DewanPieterse/AudioRadar/Report/images/pd.png

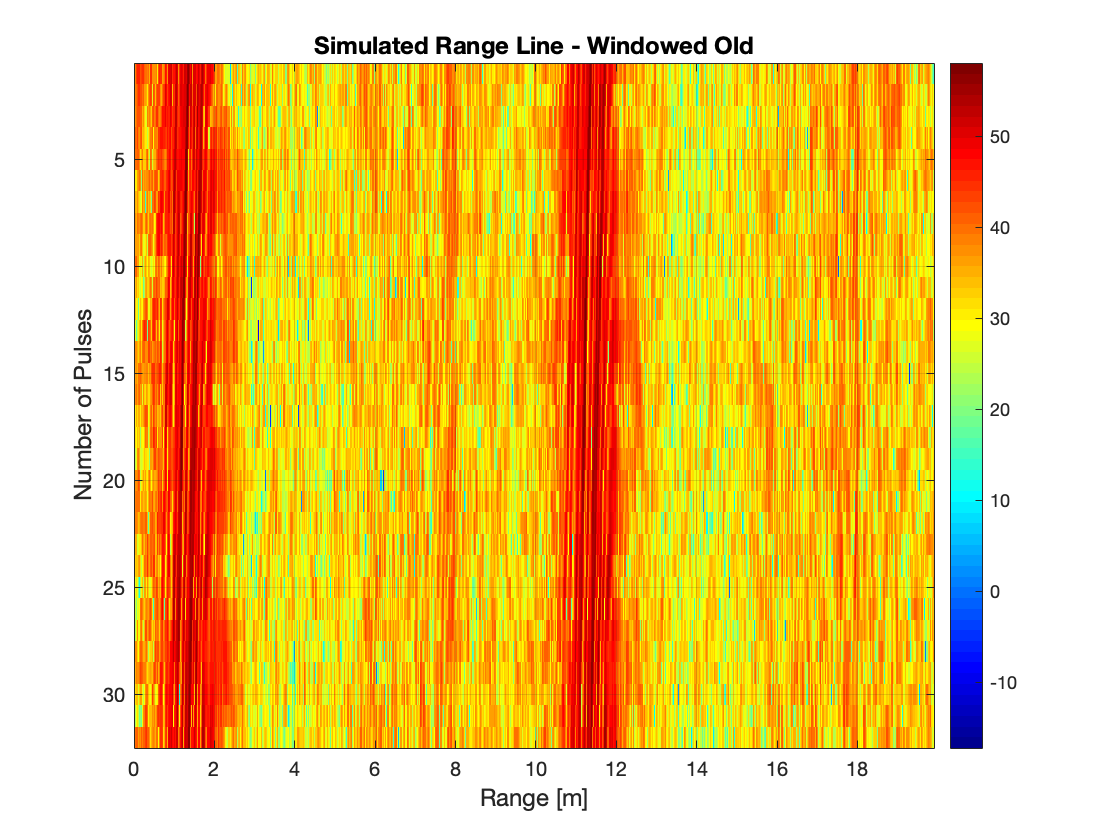
Report/images/pd.png
