DewanPieterse/AudioRadar/Matlab/Testing Mics and Speakers/IMG_0957.JPG

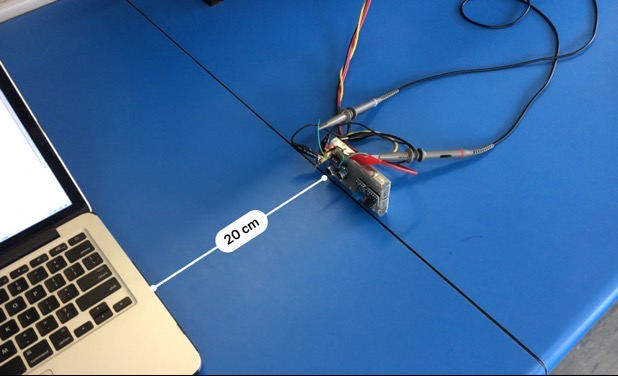
Matlab/Testing Mics and Speakers/IMG_0957.JPG
