DewanPieterse/AudioRadar/Report/Abbreviations.tex

{\smallest\chapter*{Abbreviations and Initialisms}\label{chap:Abbreviations and Initialisms}}\addcontentsline{toc}{chapter}{Abbreviations and Initialisms}\\
\hrule
\begin{table}[h!]
	\centering\renewcommand{\arraystretch}{1.5}
	\begin{tabular}{p{2cm} p{0.5cm} p{15cm}}
    ADC & & Analogue to Digital Converter \\
    CPU & & Central Processing Unit \\
	CW & & Continuous Wave \\
    DAC & & Digital to Analogue Converter \\
    dBsm & & Decibels square meter \\
    DSP & & Digital Signal Processing \\
	FFT & & Fast Fourier Transform \\
	FMCW & & Frequency Modulated Continuous Wave \\
    HAT & & Hardware Attached on Top \\
    ISM & & Industrial, Scientific and Medical frequency band \\
    MDF & & Medium Density Fibreboard \\
    MIT & & Massachusetts Institute of Technology \\
    PCB & & Printed Circuit Board \\
	PRI  & & Pulse Repetition Interval \\
    PRF & & Pulse Repetition Frequency \\
    Radar & & Radio Detection and Ranging \\
    RAM & & Random Access Memory \\
    RF & & Radio Frequency \\
	SAR & & Synthetic Aperture Radar \\
    SNR & & Signal to Noise Ratio \\
    SSH & & Secure Shell \\
    THD & & Total Harmonic Distortion \\
    UART & & Universal Asynchronous Receiver/Transmitter \\
    UCT & & University of Cape Town \\
    USB & & Universal Serial Bus \\
	\end{tabular}
\end{table}

\newpage
