DewanPieterse/AudioRadar/Report/FrontPage.tex

\thispagestyle{empty}
{\Huge 
\begin{center}
    Development of a Small-Scale, Educational, Embedded, Audio Radar System
    % Title
\end{center}}

\vskip 5mm
\begin{center}
    
\end{center}

\vskip 5mm
\begin{center}
    Presented by:\\
    \textbf{Dewan Pieterse}\\
    PTRDEW001\\
    Department of Electrical and Electronics Engineering\\
    University of Cape Town
\end{center}

\vskip 10mm
\begin{center}
Prepared for:\\
    \textbf{Dr. Mohammed Yunus Abdul Gaffar}\\ % and Mr. Jarryd Son} \\
    Department of Electrical and Electronics Engineering\\
    University of Cape Town
\end{center}

\vskip 10mm
\begin{center}{\scriptsize
Submitted to the Department of Electrical Engineering at the University of Cape Town in partial fulfilment of the academic requirements for a Bachelor of Science degree in Mechatronics Engineering}
\end{center}

\vskip 5mm
\begin{center}{\bf \today}\end{center}

\begin{center}\textbf{Key words:} Education, Radar, Audio, Embedded Systems, Low-Cost\end{center}\newpage
