DewanPieterse/AudioRadar/Report/Plagiarism.tex

{\smallest\chapter*{Plagiarism Declaration}\label{chap:Plagiarism Declaration}}\addcontentsline{toc}{chapter}{Plagiarism Declaration}\\
\hrule

\vskip 10mm
\begin{enumerate}
\item I know that plagiarism is wrong. Plagiarism is to use another's work and pretend that it is one's own.
\item I have used the IEEE convention for citation and referencing. Each contribution to, and quotation in, this report from the work(s) of other people has been attributed, and has been cited and referenced.
\item This report is my own work.
\item I have not allowed, and will not allow, anyone to copy my work with the intention of passing it off as their own work or part thereof.
\end{enumerate}

\vskip 15mm
\ldots\ldots\ldots\ldots\ldots\ldots\ldots\ldots\ldots\ldots
\\D. Pieterse
\vskip12mm
\ldots\ldots\ldots\ldots\ldots\ldots\ldots\ldots\ldots\ldots
\\Date

\fancyfoot[C]{\thepage}
\pagestyle{plain}
\newpage
