DewanPieterse/AudioRadar/Report/images/9000.pdf

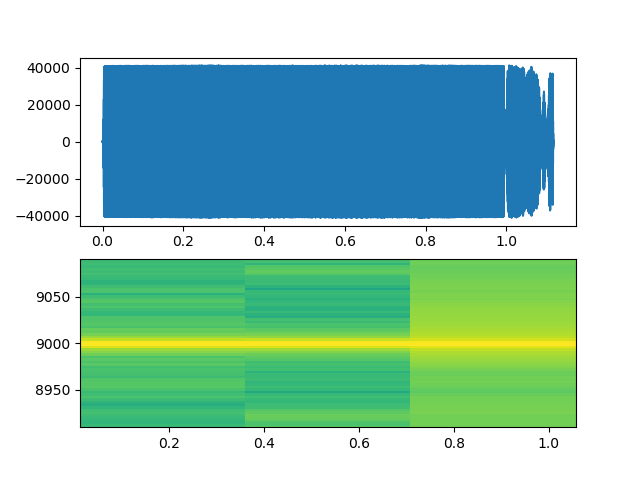
[picture p3: page 1]
