DewanPieterse/AudioRadar/Report/images/ampfreq.pdf

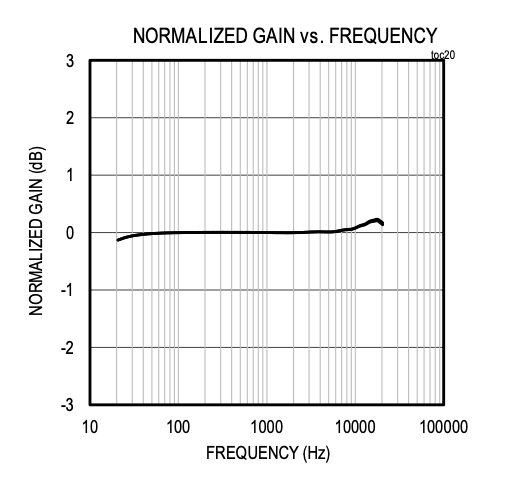
[picture p4: page 1]
