DewanPieterse/AudioRadar/Report/images/boxToward.pdf

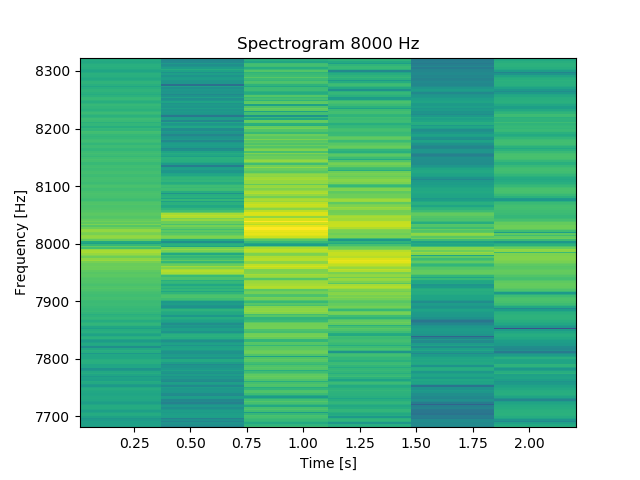
[picture p5: page 1]
