DewanPieterse/AudioRadar/Report/images/chirp.pdf

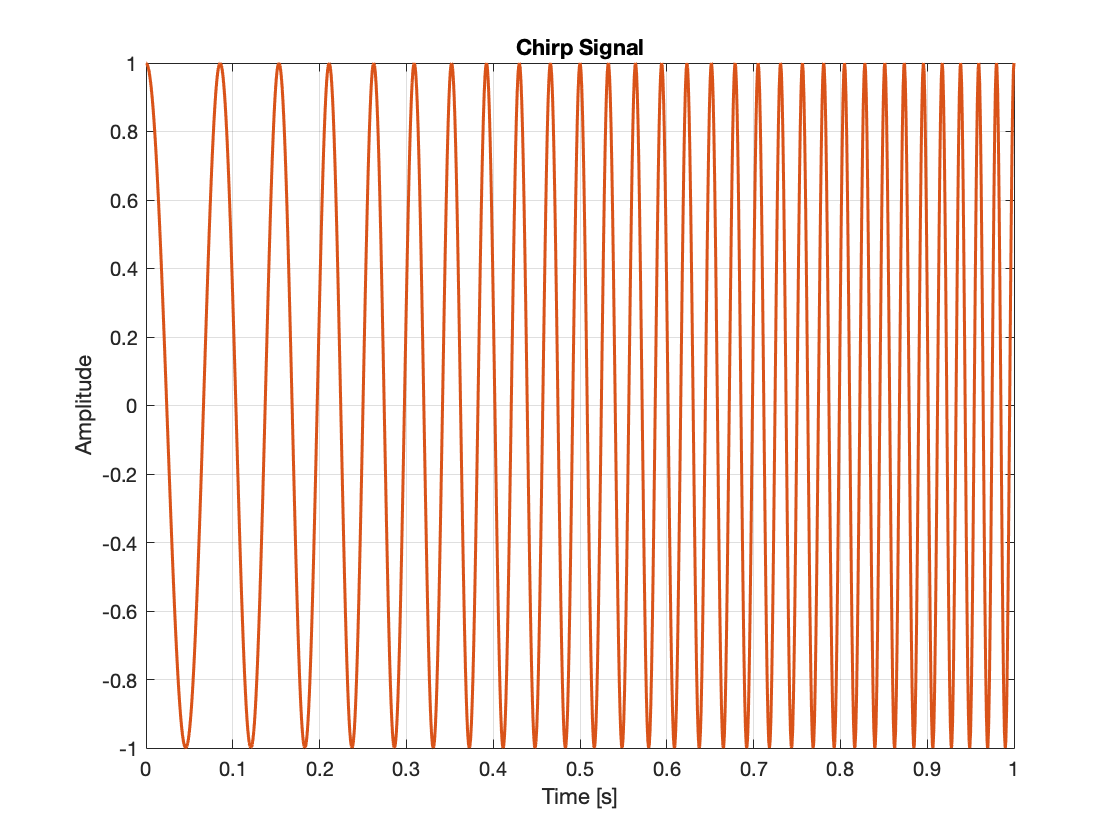
[picture p6: page 1]
