DewanPieterse/AudioRadar/Report/images/chirpFFT.pdf

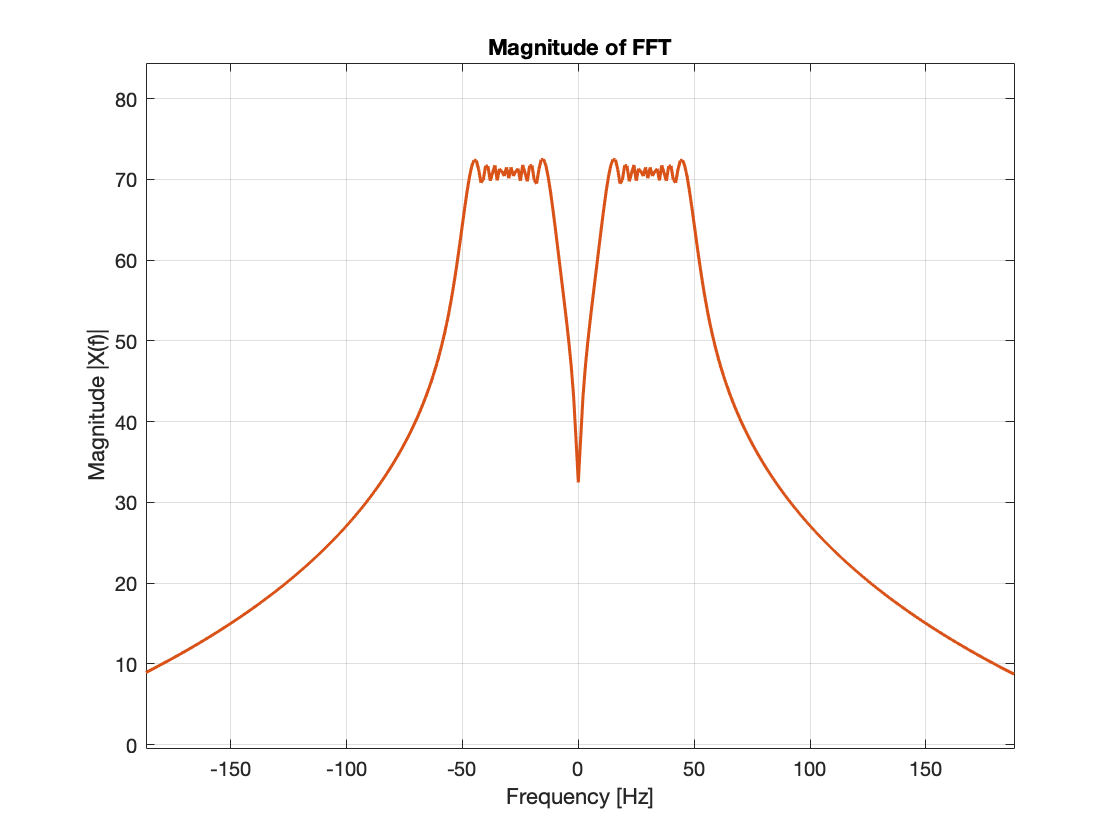
[picture p7: page 1]
