DewanPieterse/AudioRadar/Report/images/consistPDResults1.pdf

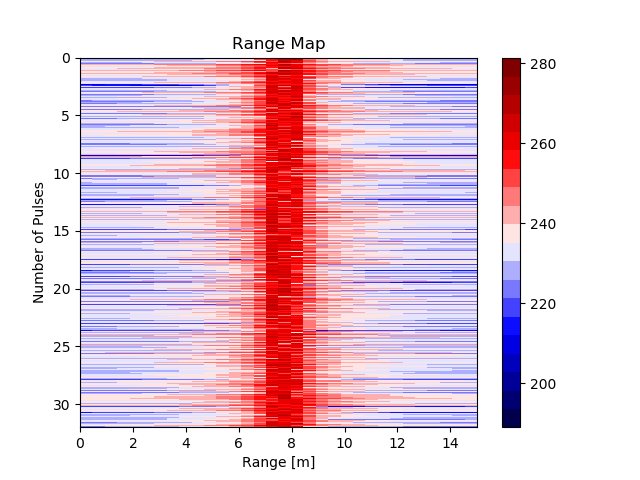
[picture p8: page 1]
