DewanPieterse/AudioRadar/Report/images/consistPDResults2.pdf

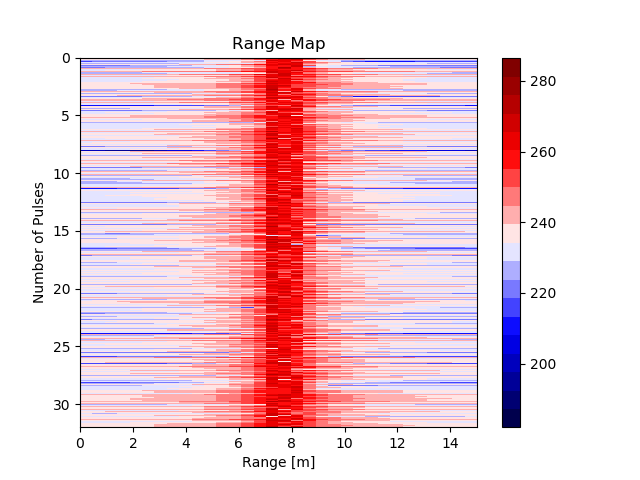
[picture p9: page 1]
