DewanPieterse/AudioRadar/Report/images/consistPDResults3.pdf

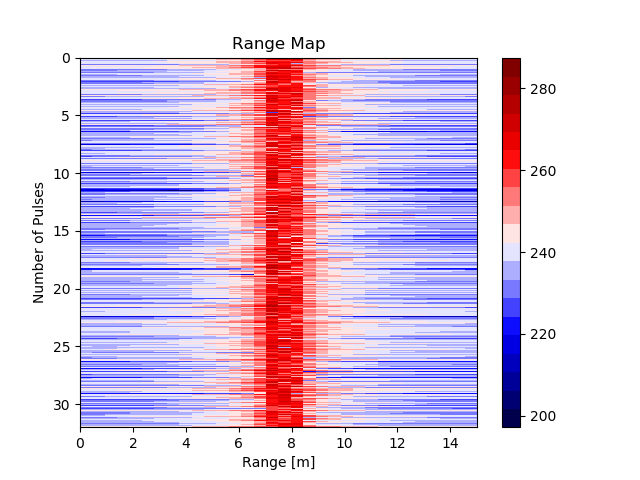
[picture p10: page 1]
