DewanPieterse/AudioRadar/Report/images/CW.pdf

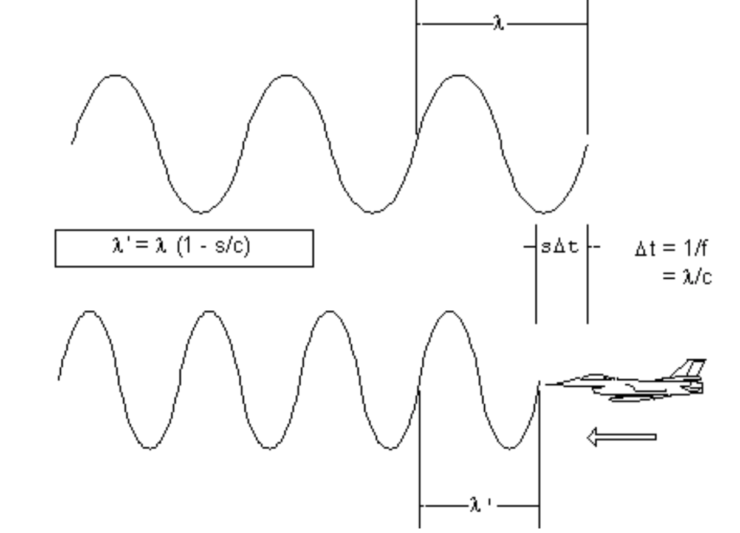
[picture p11: page 1]
