DewanPieterse/AudioRadar/Report/images/CWResults1.pdf

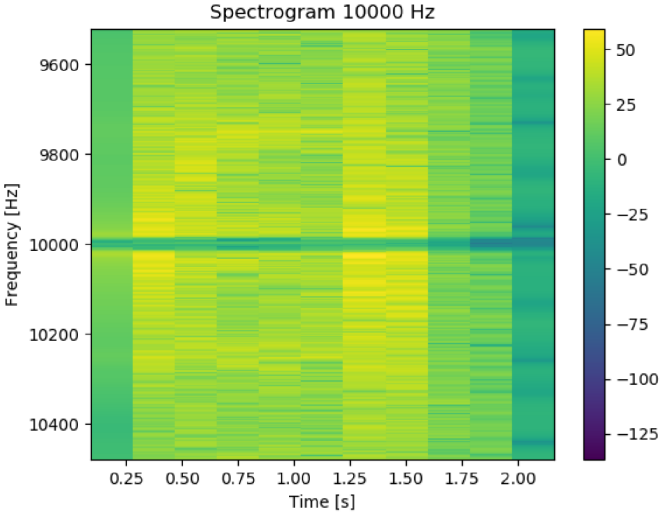
[picture p12: page 1]
