DewanPieterse/AudioRadar/Report/images/CWResults2.pdf

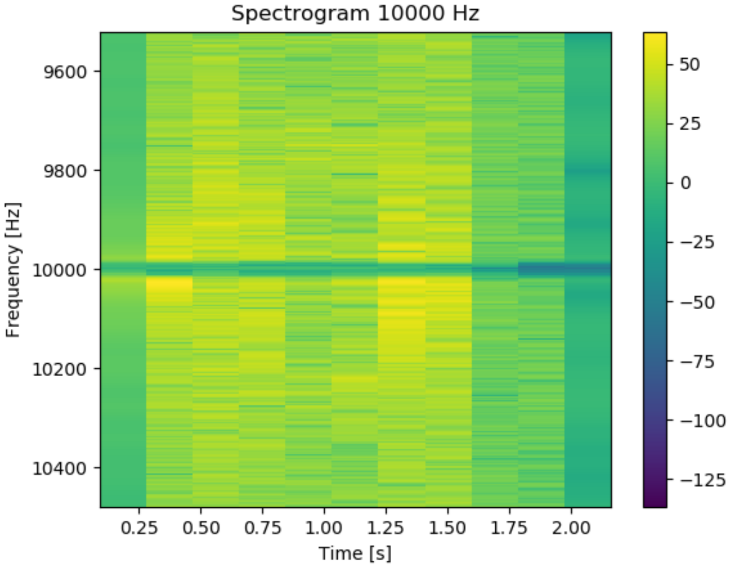
[picture p13: page 1]
