DewanPieterse/AudioRadar/Report/images/CWResults3.pdf

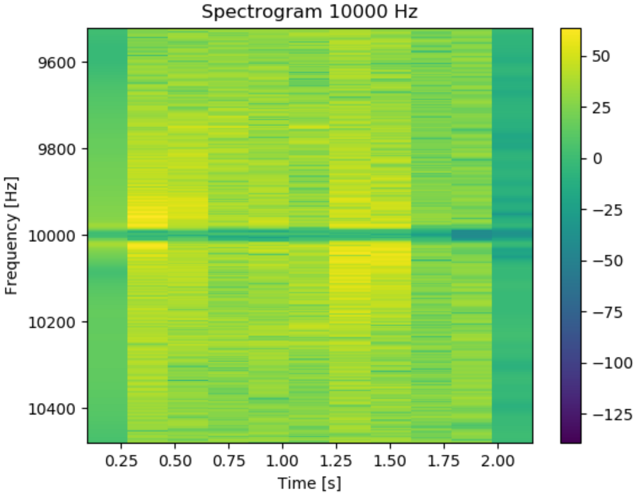
[picture p14: page 1]
