DewanPieterse/AudioRadar/Report/images/cwSpec.pdf

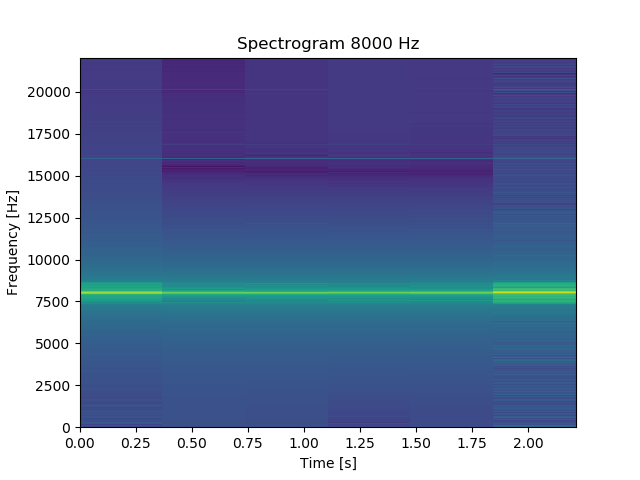
[picture p15: page 1]
