DewanPieterse/AudioRadar/Report/images/cwSpec1.pdf

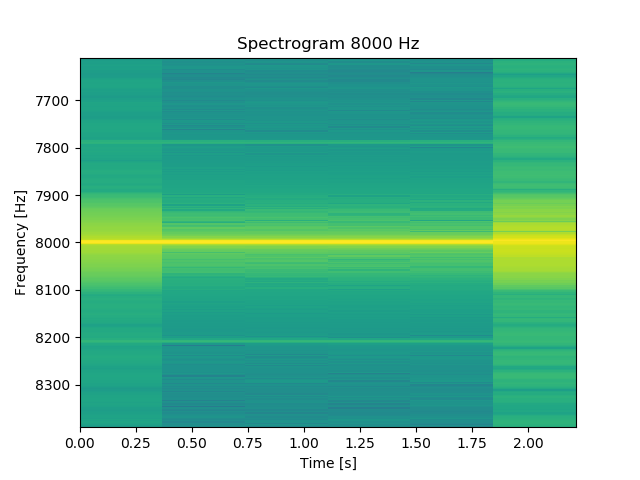
[picture p16: page 1]
