DewanPieterse/AudioRadar/Report/images/dist.pdf

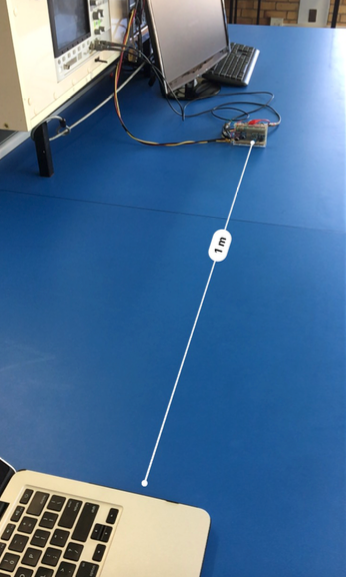
[picture p17: page 1]
