DewanPieterse/AudioRadar/Report/images/downmix.pdf

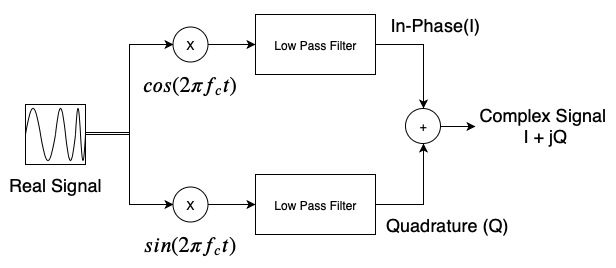
[picture p18: page 1]
