DewanPieterse/AudioRadar/Report/images/enc1.pdf

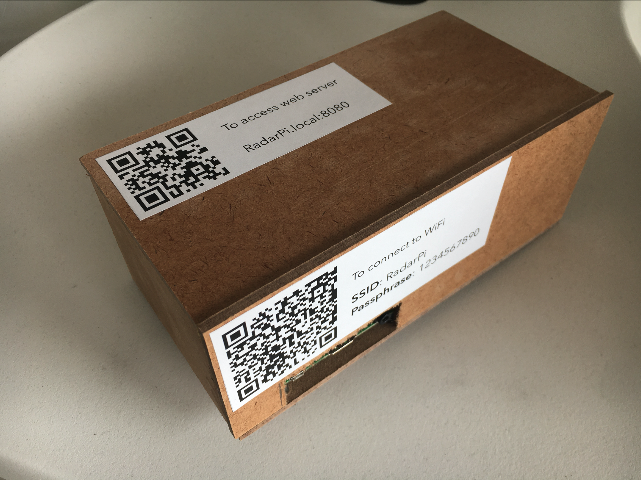
[picture p19: page 1]
