DewanPieterse/AudioRadar/Report/images/enc2.pdf

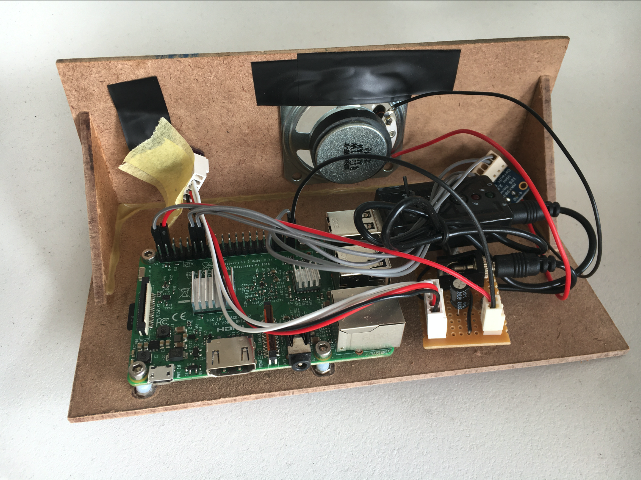
[picture p20: page 1]
