DewanPieterse/AudioRadar/Report/images/enc3.pdf

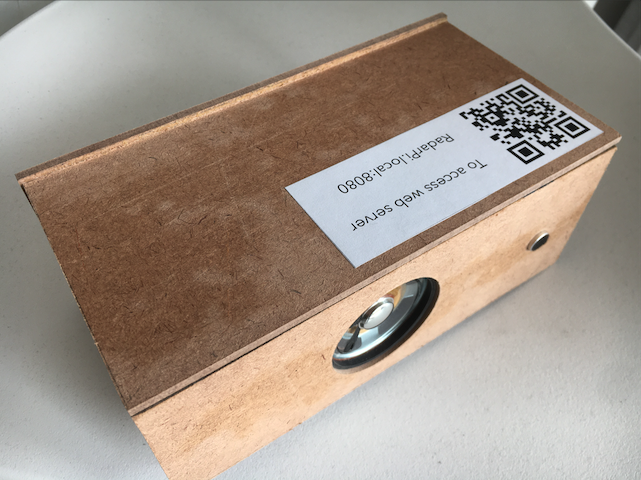
[picture p21: page 1]
