DewanPieterse/AudioRadar/Report/images/fftTeensy.pdf

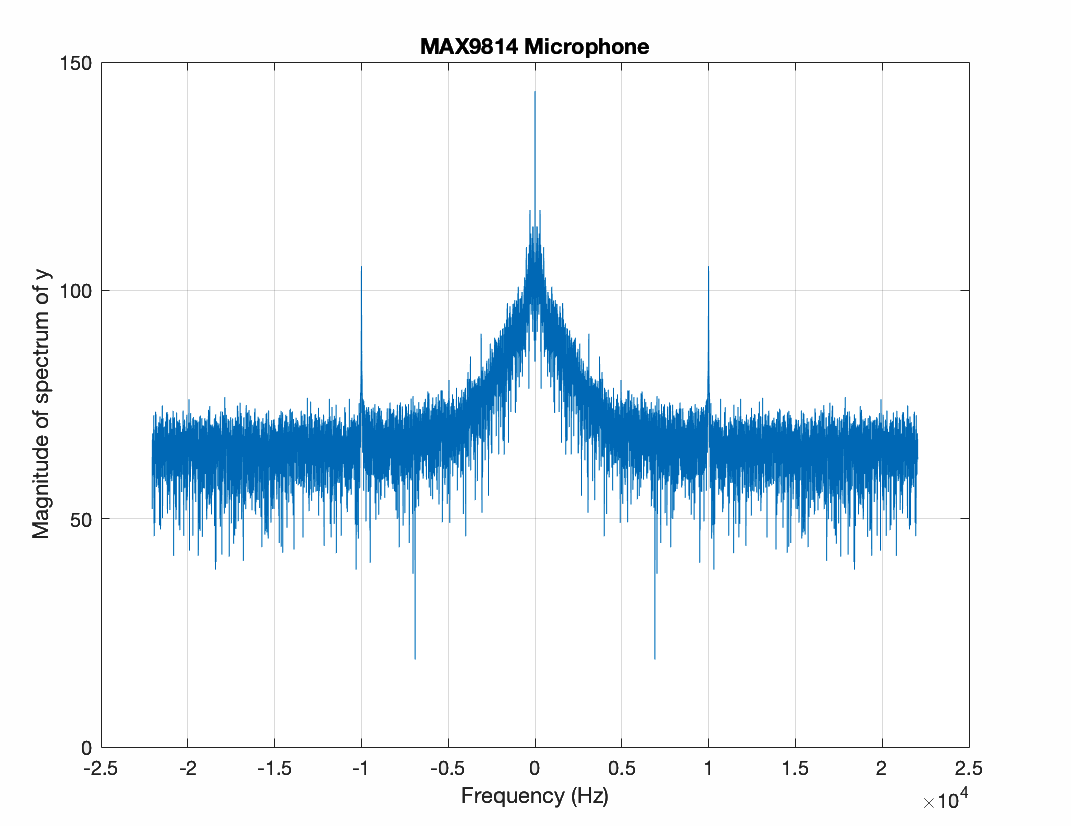
[picture p22: page 1]
