DewanPieterse/AudioRadar/Report/images/floorplan.pdf

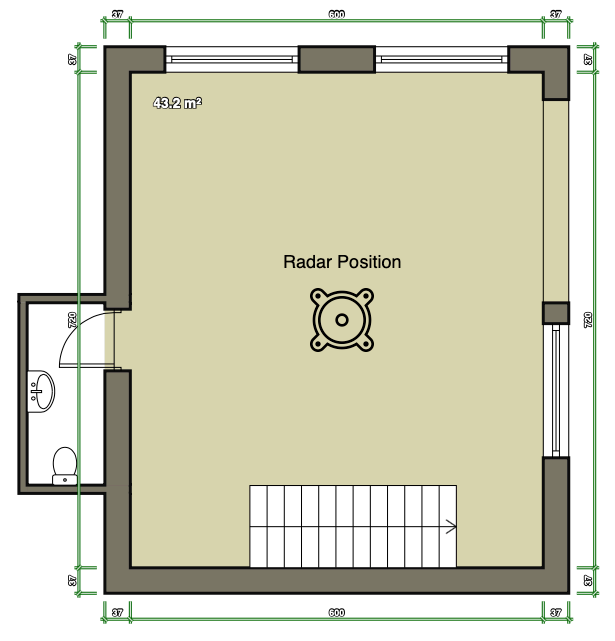
[picture p23: page 1]
