DewanPieterse/AudioRadar/Report/images/FMCW.pdf

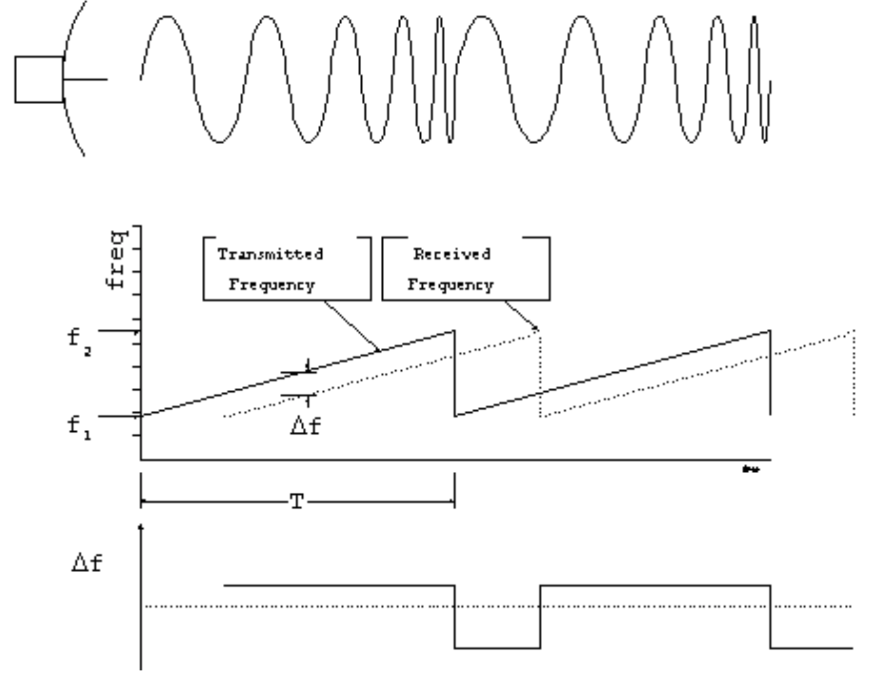
[picture p24: page 1]
