DewanPieterse/AudioRadar/Report/images/gainVSfreq.pdf

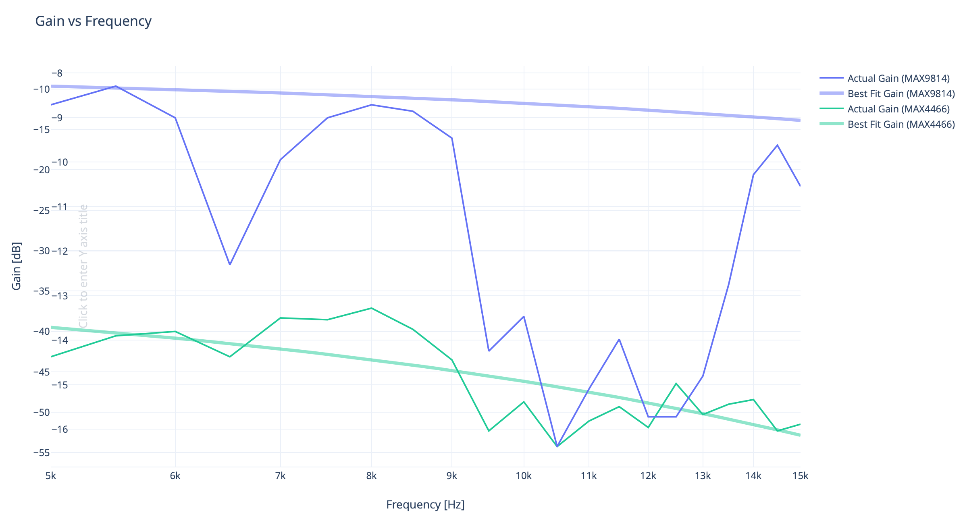
[picture p25: page 1]
