DewanPieterse/AudioRadar/Report/images/golfball.pdf

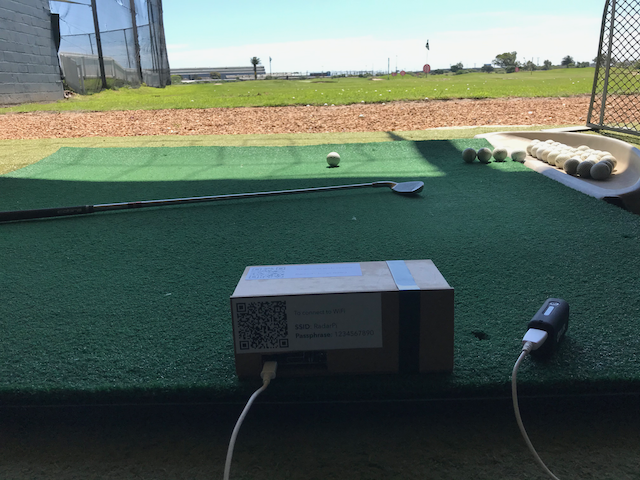
[picture p26: page 1]
