DewanPieterse/AudioRadar/Report/images/hamming.pdf

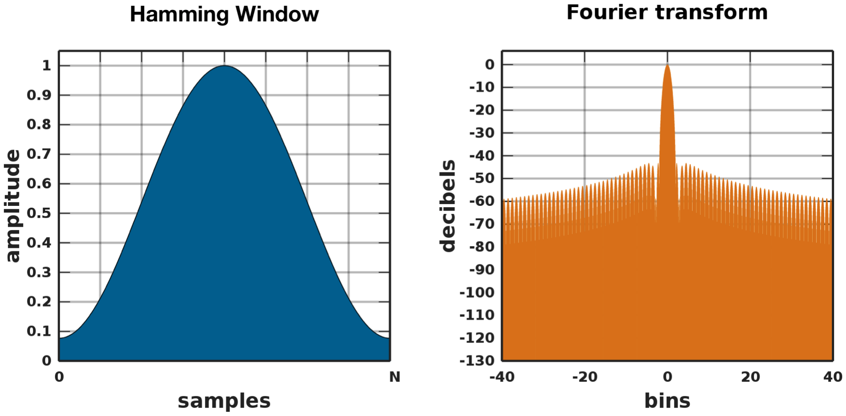
[picture p27: page 1]
