DewanPieterse/AudioRadar/Report/images/handmoving.pdf

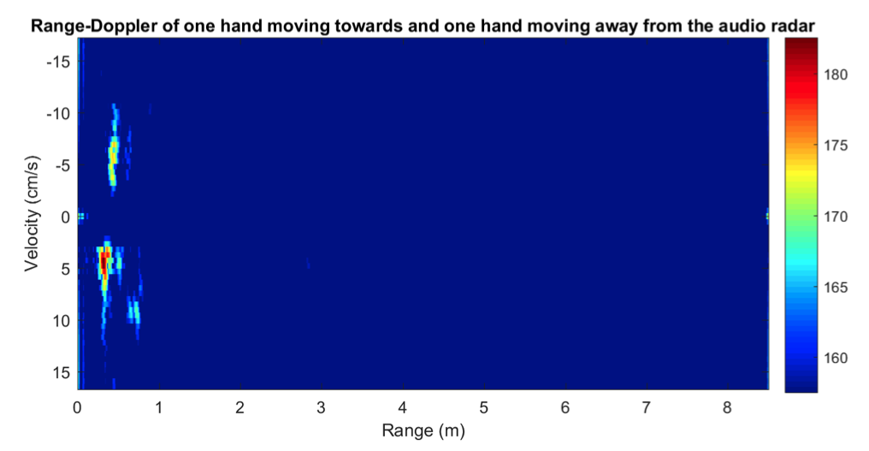
[picture p28: page 1]
