DewanPieterse/AudioRadar/Report/images/handsfingers.pdf

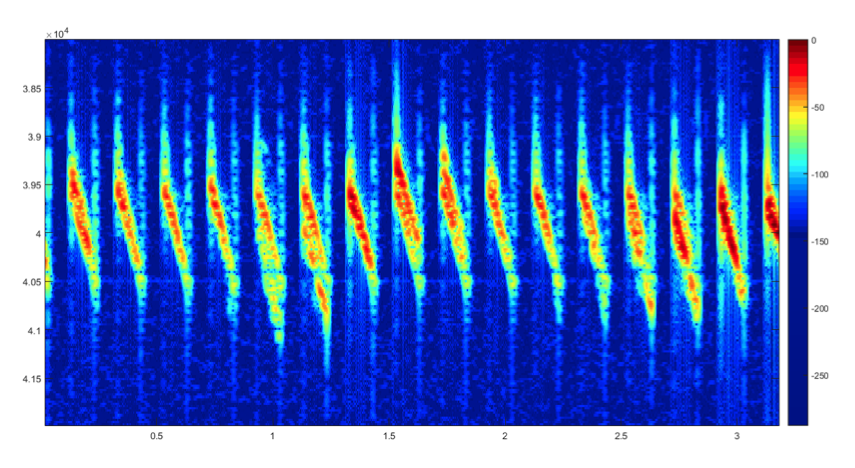
[picture p29: page 1]
