DewanPieterse/AudioRadar/Report/images/implementationCircuit.pdf

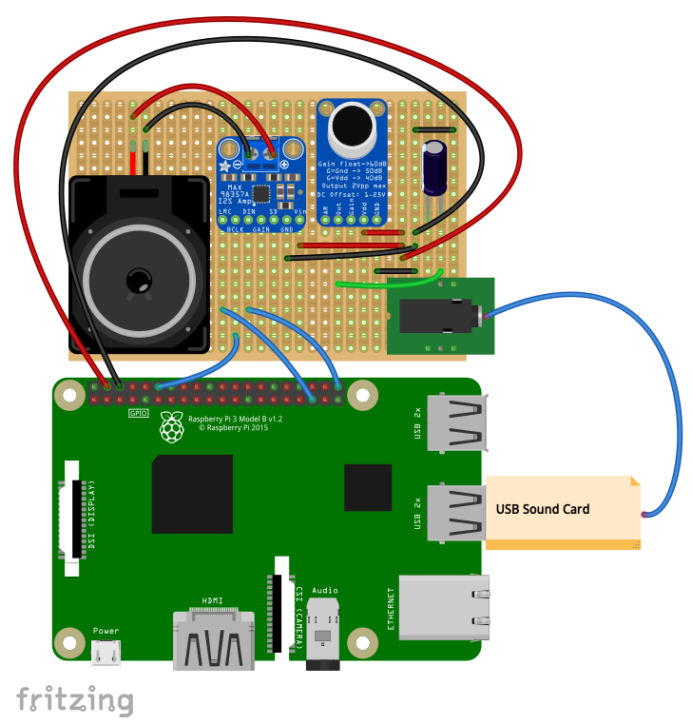
[picture p30: page 1]
