DewanPieterse/AudioRadar/Report/images/lidOff.pdf

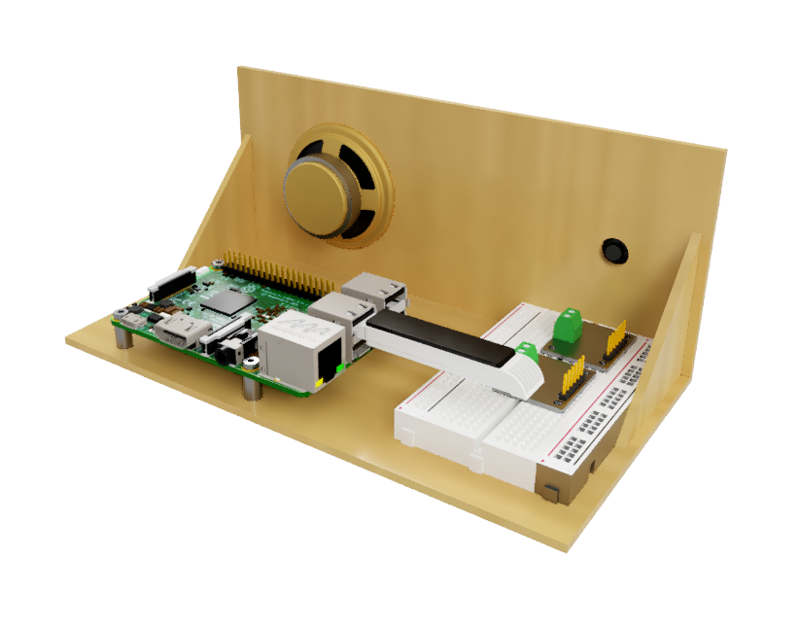
[picture p31: page 1]
