DewanPieterse/AudioRadar/Report/images/lidOn.pdf

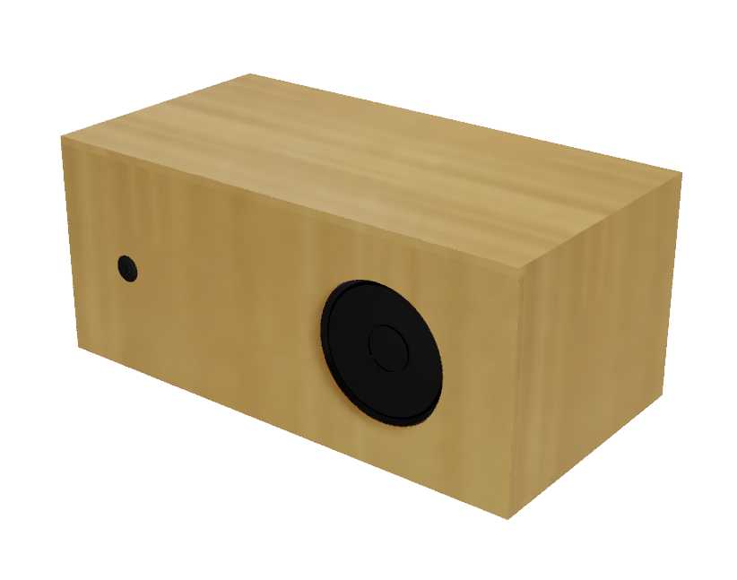
[picture p32: page 1]
