DewanPieterse/AudioRadar/Report/images/lowcostminiradar.pdf

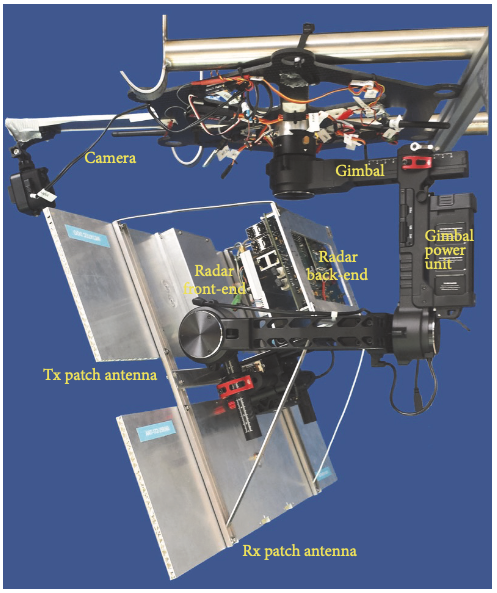
[picture p33: page 1]
