DewanPieterse/AudioRadar/Report/images/lowcostradar.pdf

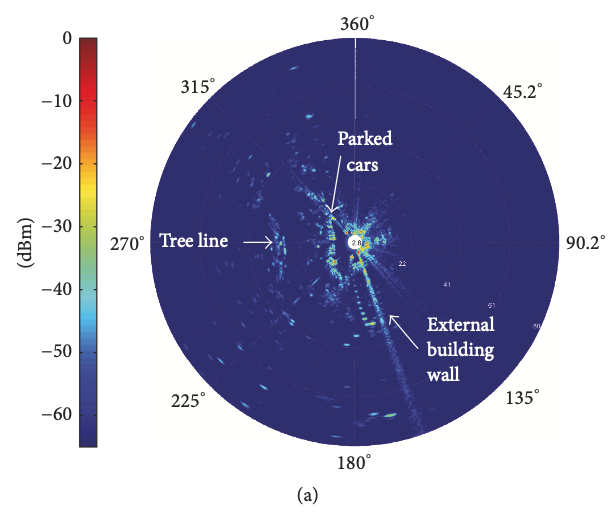
[picture p34: page 1]
