DewanPieterse/AudioRadar/Report/images/lpfDownmix.pdf

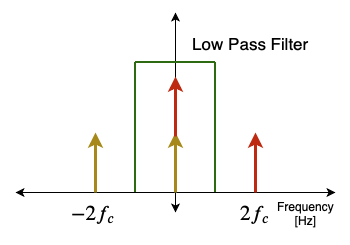
[picture p35: page 1]
