DewanPieterse/AudioRadar/Report/images/MAX4466.pdf

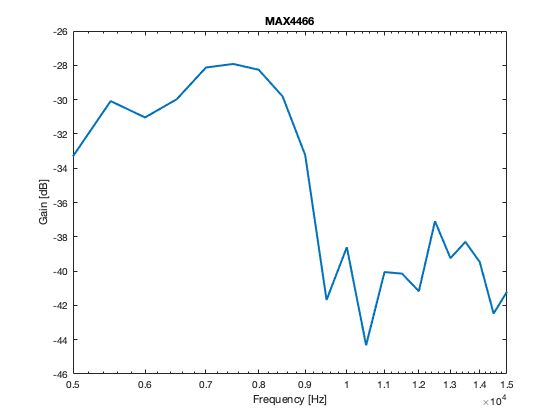
[picture p36: page 1]
