DewanPieterse/AudioRadar/Report/images/MAX9814.pdf

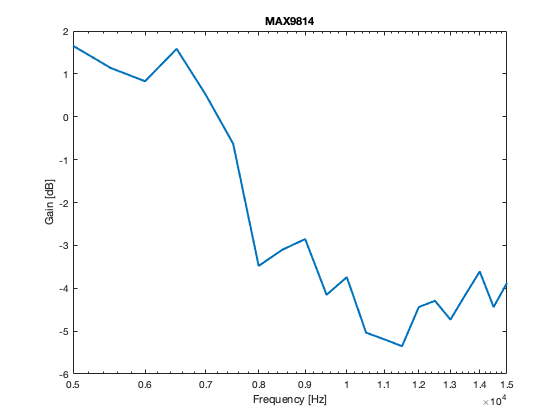
[picture p37: page 1]
