DewanPieterse/AudioRadar/Report/images/mcp3008.pdf

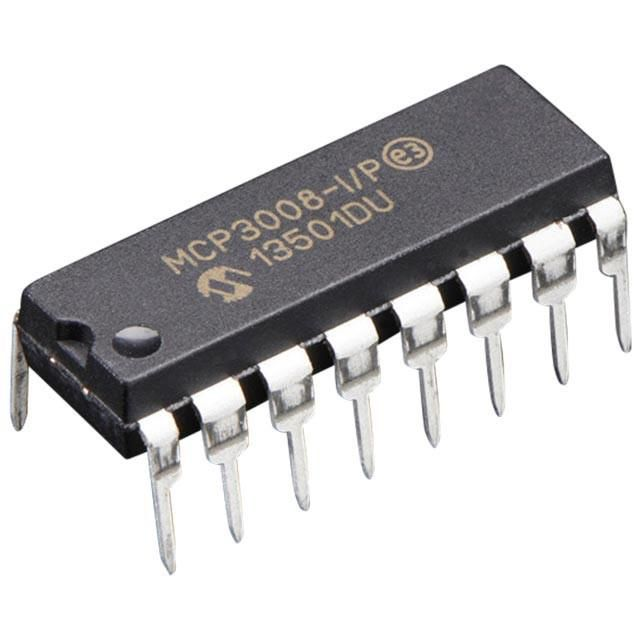
[picture p38: page 1]
