DewanPieterse/AudioRadar/Report/images/mf.pdf

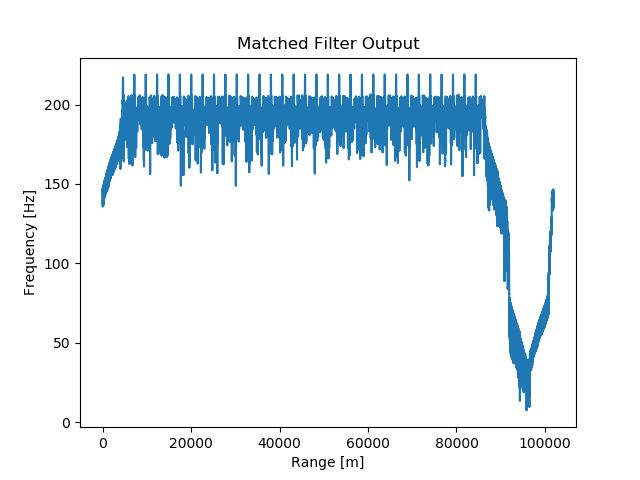
[picture p39: page 1]
