DewanPieterse/AudioRadar/Report/images/mfIll.pdf

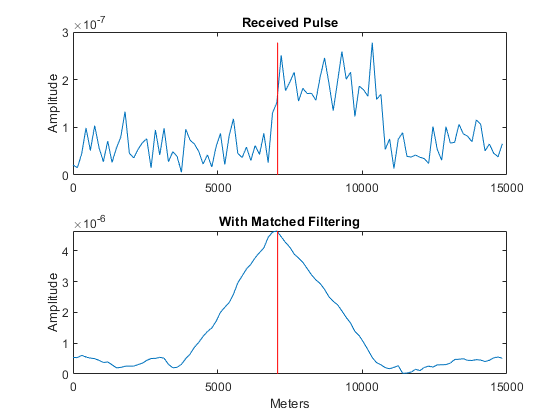
[picture p40: page 1]
