DewanPieterse/AudioRadar/Report/images/mic.pdf

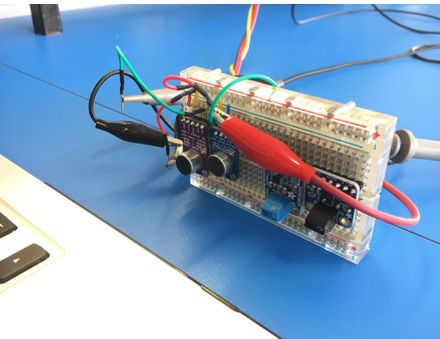
[picture p41: page 1]
