DewanPieterse/AudioRadar/Report/images/MITRadar.pdf

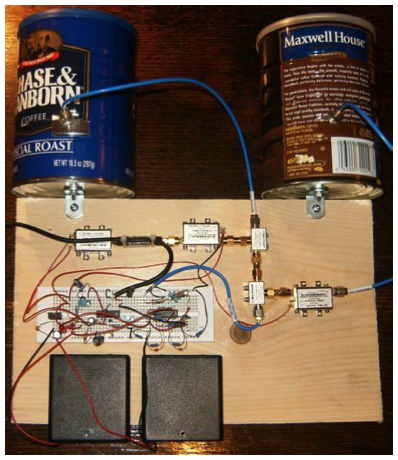
[picture p42: page 1]
