DewanPieterse/AudioRadar/Report/images/notchApplied.pdf

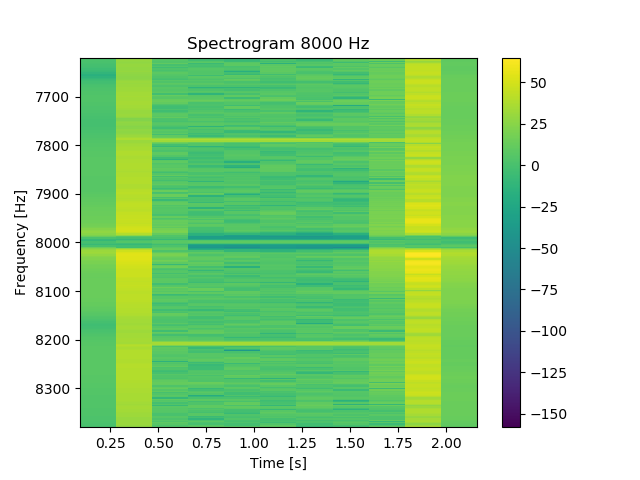
[picture p43: page 1]
