DewanPieterse/AudioRadar/Report/images/overview.pdf

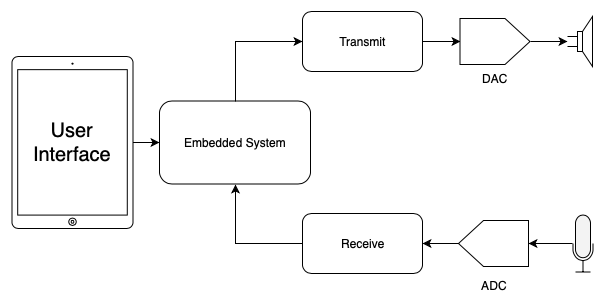
[picture p44: page 1]
