DewanPieterse/AudioRadar/Report/images/PRI.pdf

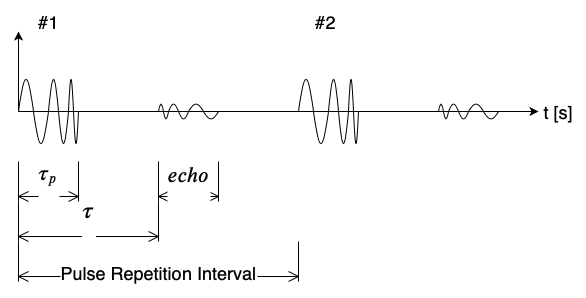
[picture p45: page 1]
