DewanPieterse/AudioRadar/Report/images/ra1.pdf

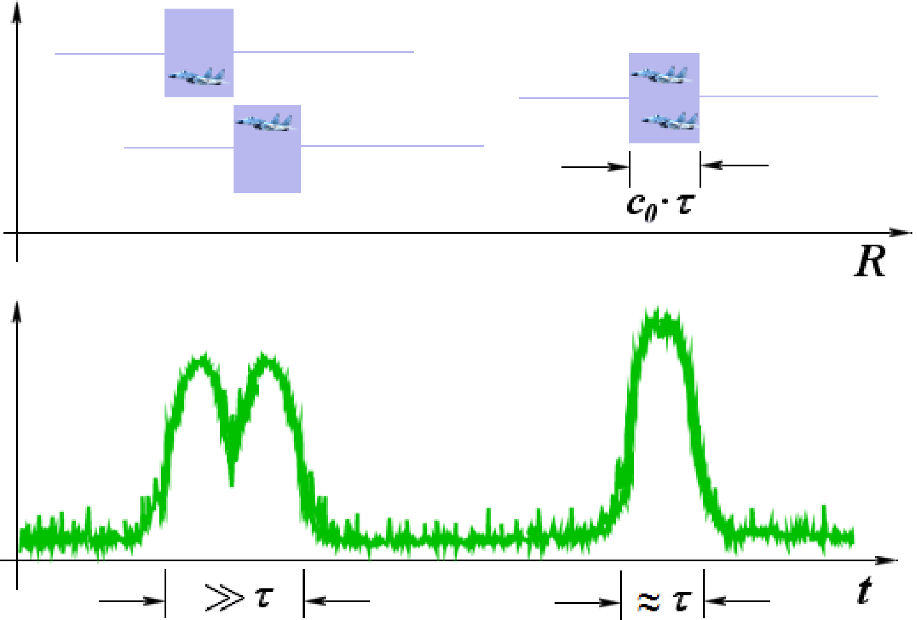
[picture p46: page 1]
