DewanPieterse/AudioRadar/Report/images/rangeConcept.pdf

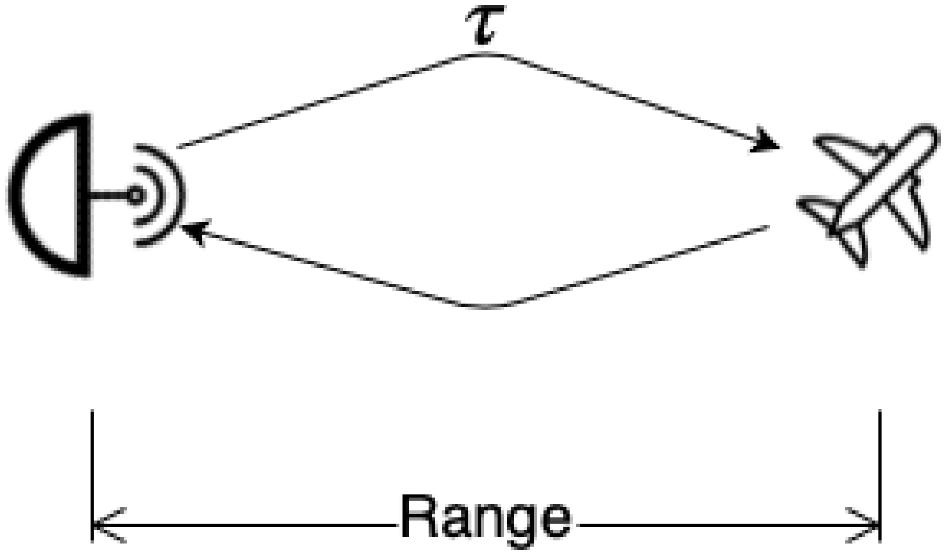
[picture p47: page 1]
