DewanPieterse/AudioRadar/Report/images/rangeline2Matrix.pdf

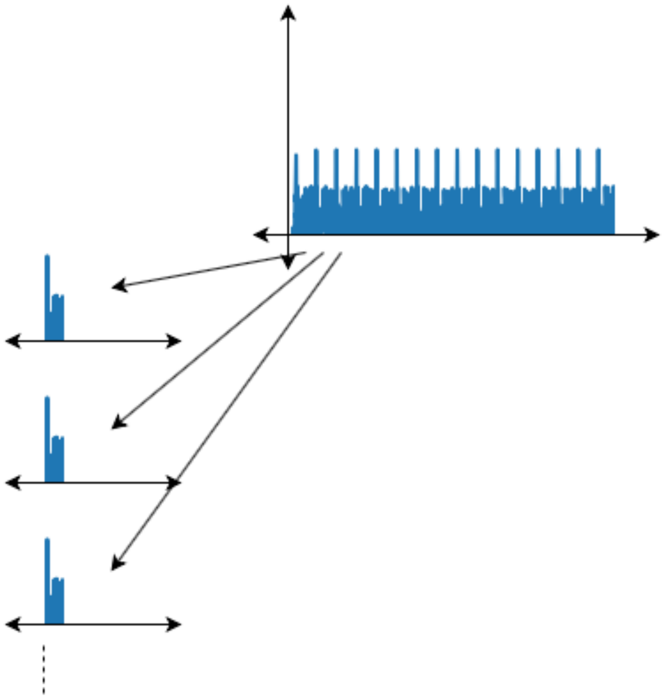
[picture p48: page 1]
