DewanPieterse/AudioRadar/Report/images/rangemap.pdf

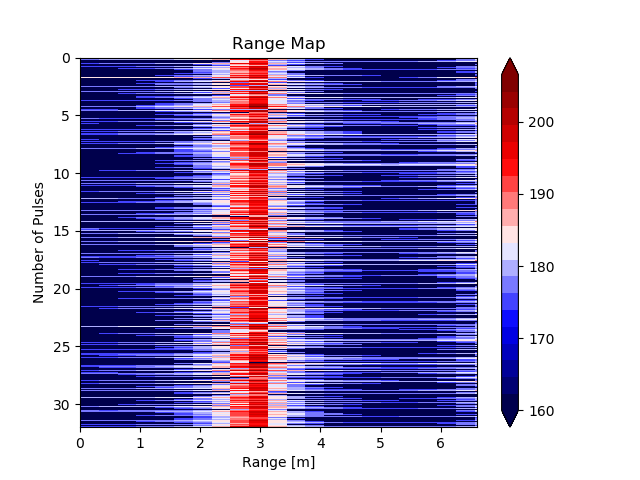
[picture p49: page 1]
