DewanPieterse/AudioRadar/Report/images/RangeU.pdf

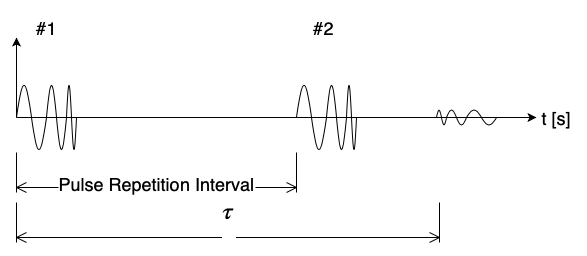
[picture p50: page 1]
