DewanPieterse/AudioRadar/Report/images/rpi3b.pdf

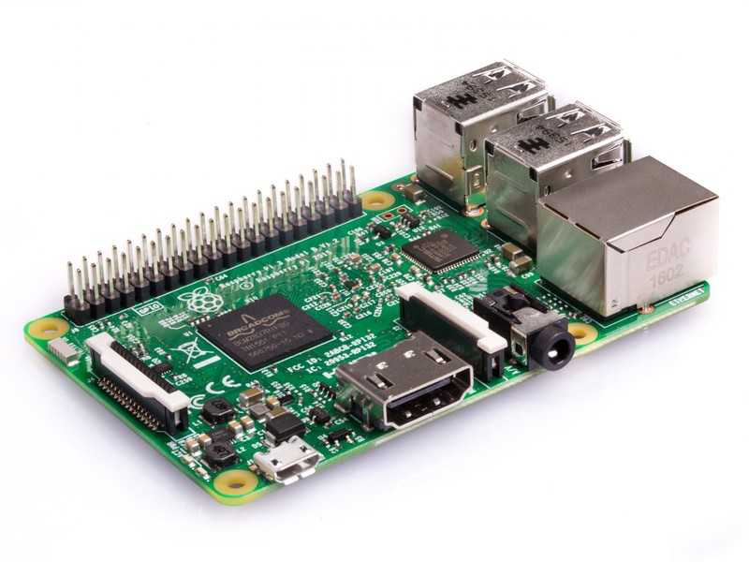
[picture p51: page 1]
