DewanPieterse/AudioRadar/Report/images/RSPro1W.pdf

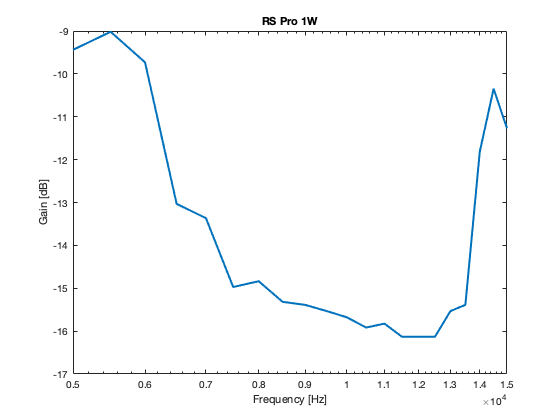
[picture p52: page 1]
