DewanPieterse/AudioRadar/Report/images/RSPro2W.pdf

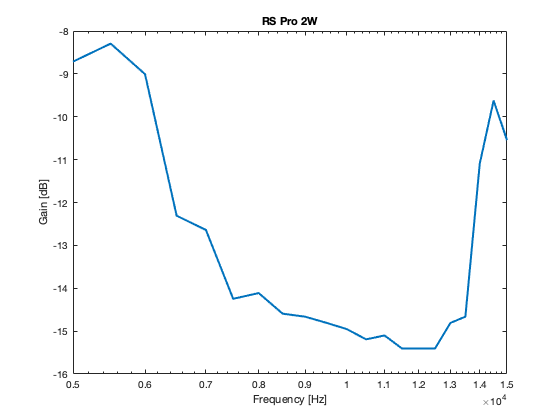
[picture p53: page 1]
