DewanPieterse/AudioRadar/Report/images/rxSig.pdf

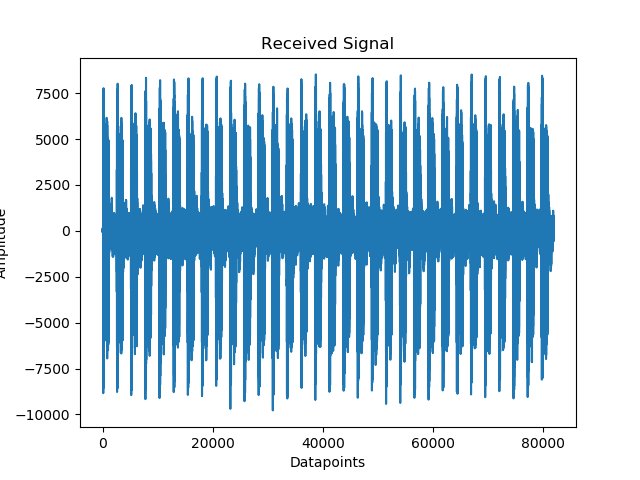
[picture p54: page 1]
