DewanPieterse/AudioRadar/Report/images/scope_5.pdf

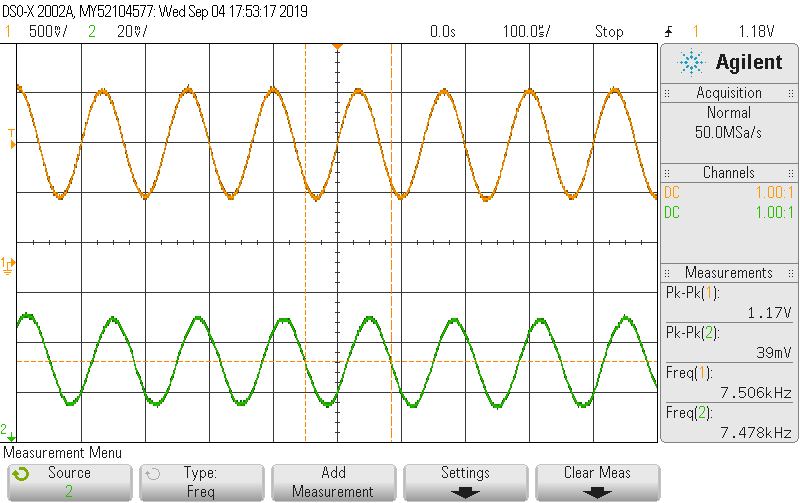
[picture p55: page 1]
