DewanPieterse/AudioRadar/Report/images/soundTeensy.pdf

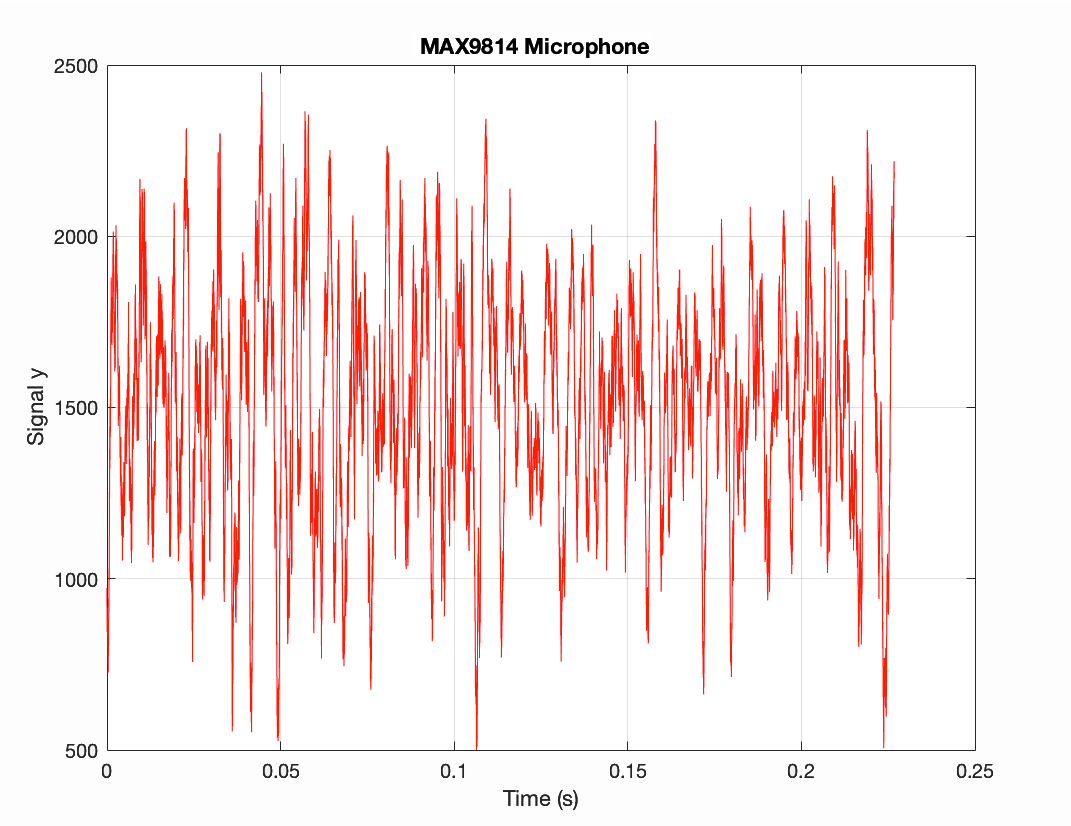
[picture p56: page 1]
