DewanPieterse/AudioRadar/Report/images/stop.pdf

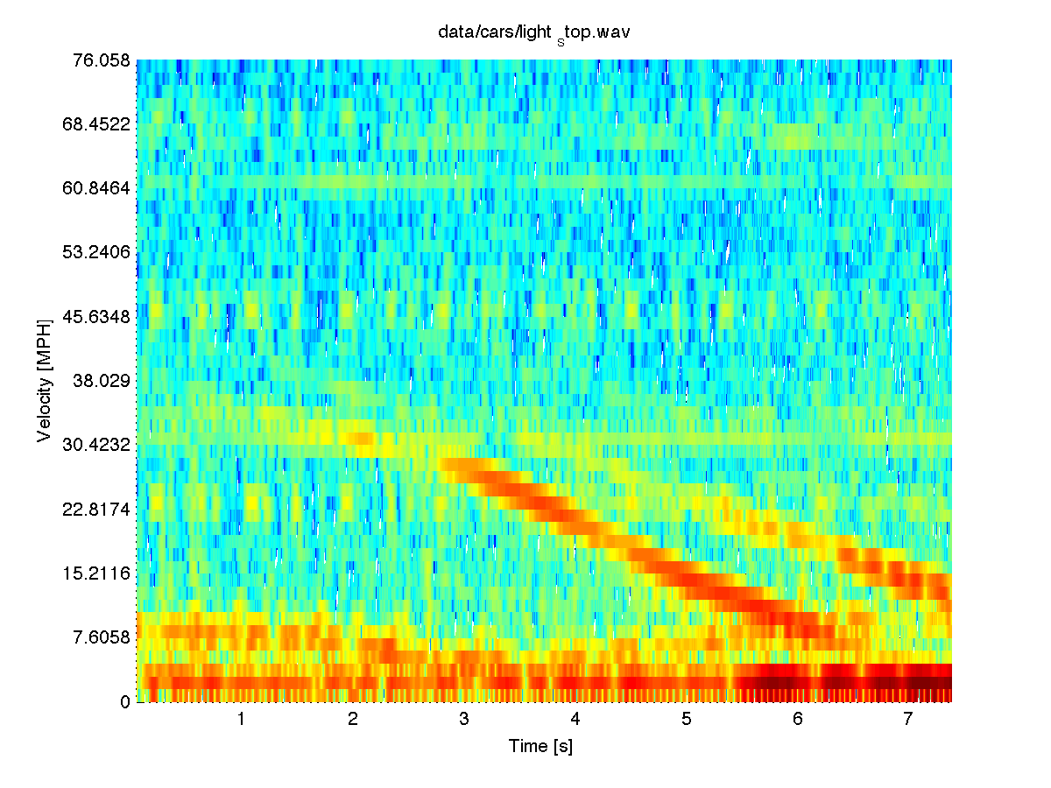
[picture p57: page 1]
