DewanPieterse/AudioRadar/Report/images/susp.pdf

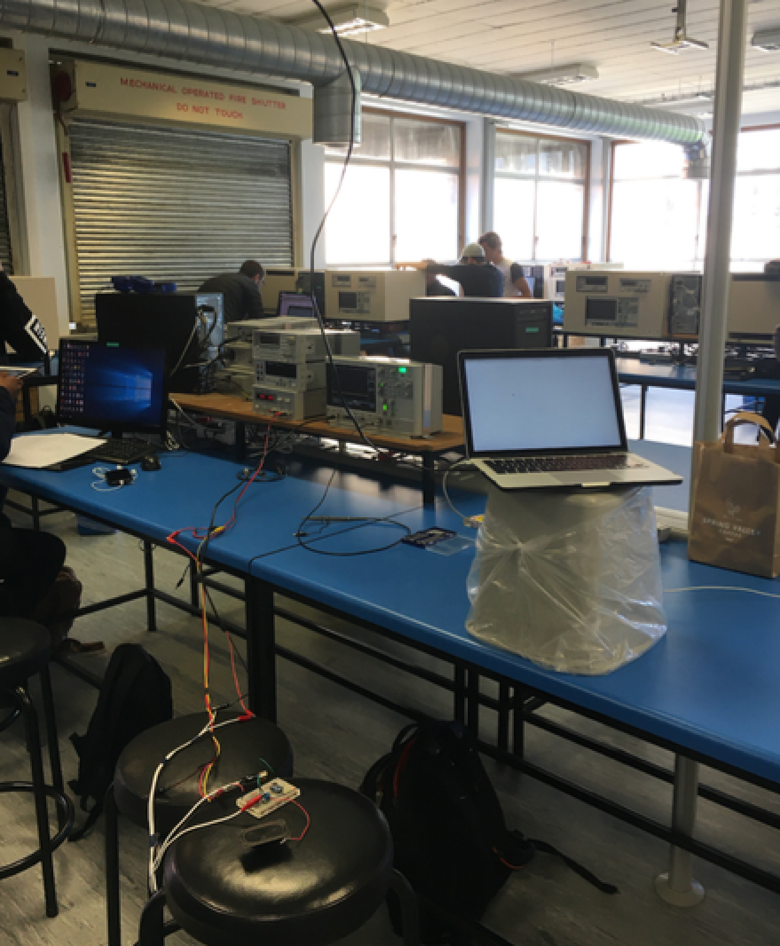
[picture p58: page 1]
