DewanPieterse/AudioRadar/Report/images/teensy36.pdf

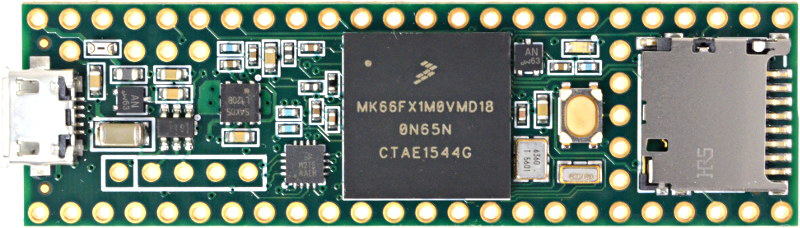
[picture p59: page 1]
