DewanPieterse/AudioRadar/Report/images/teensy3_audio.pdf

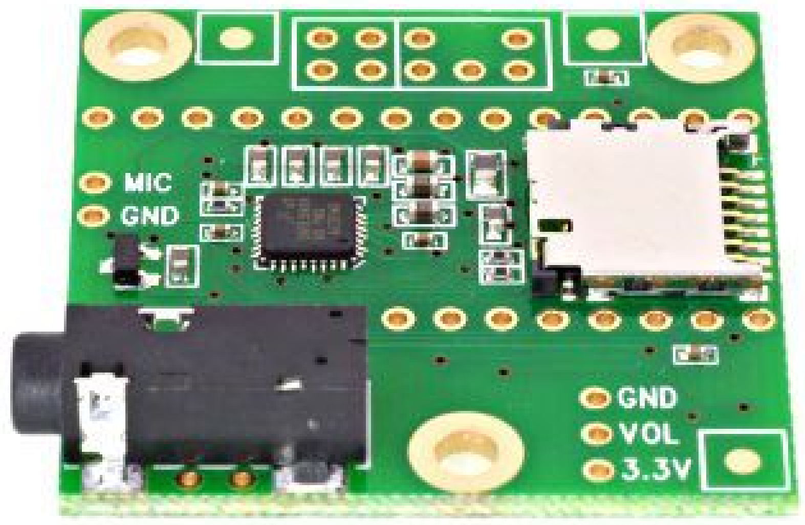
[picture p60: page 1]
