DewanPieterse/AudioRadar/Report/images/teensyfft.pdf

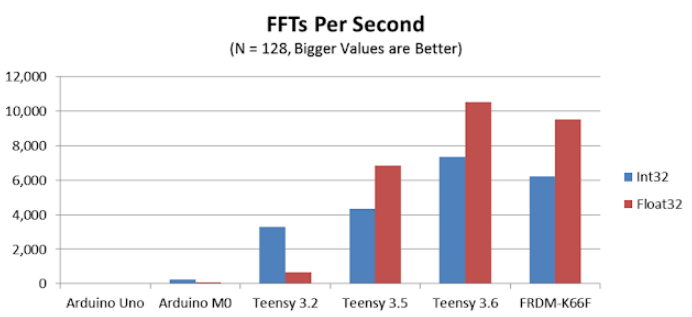
[picture p61: page 1]
