DewanPieterse/AudioRadar/Report/images/setup1.pdf

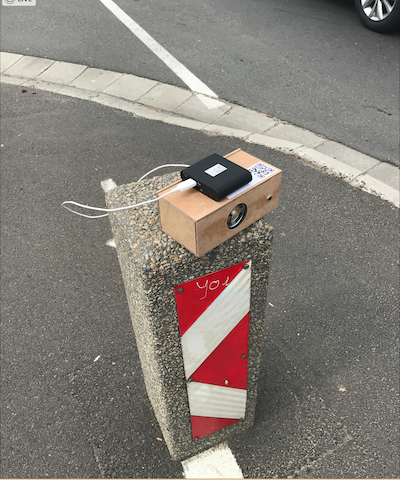
[picture p62: page 1]
