DewanPieterse/AudioRadar/Report/images/setup2.pdf

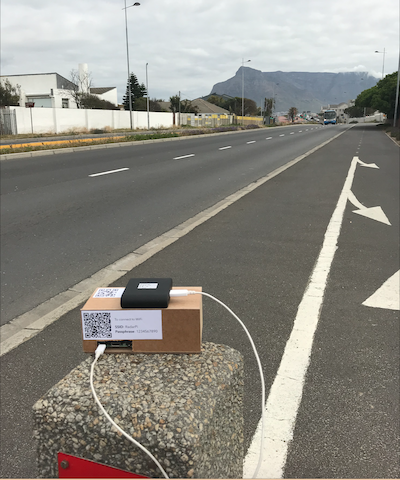
[picture p63: page 1]
