DewanPieterse/AudioRadar/Report/images/setupCWConsisresults.pdf

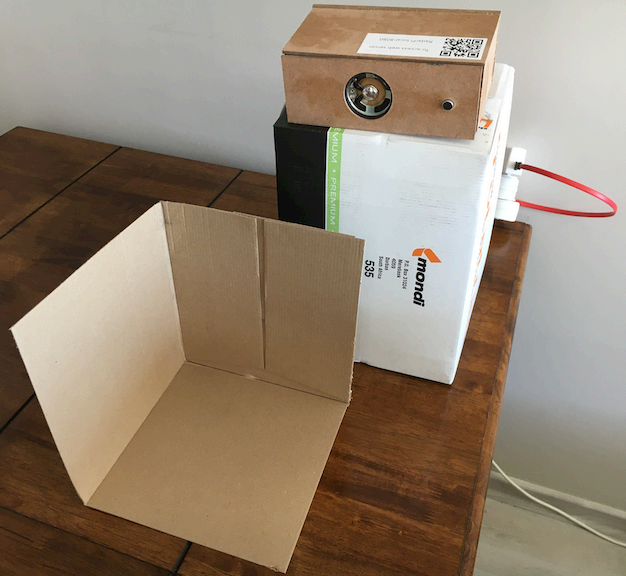
[picture p64: page 1]
