DewanPieterse/AudioRadar/Report/images/setupPDresults.pdf

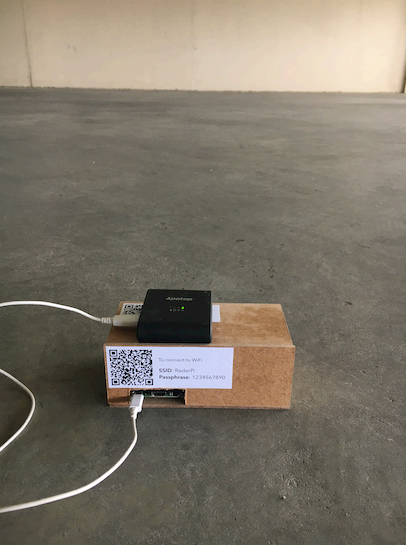
[picture p65: page 1]
