DewanPieterse/AudioRadar/Report/images/setupPDresults1.pdf

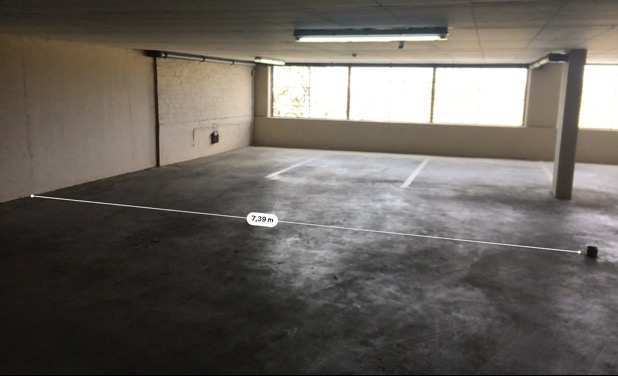
[picture p66: page 1]
