DewanPieterse/AudioRadar/Report/images/setupPDTest1.pdf

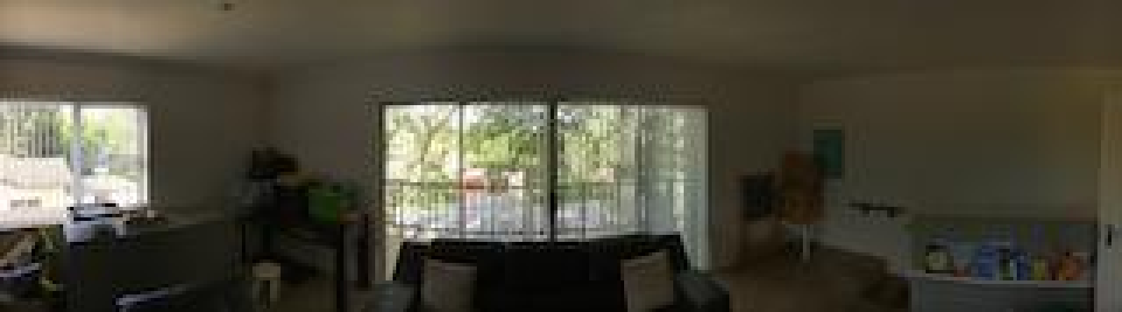
[picture p67: page 1]
