DewanPieterse/AudioRadar/Report/images/setupPDTest2.pdf

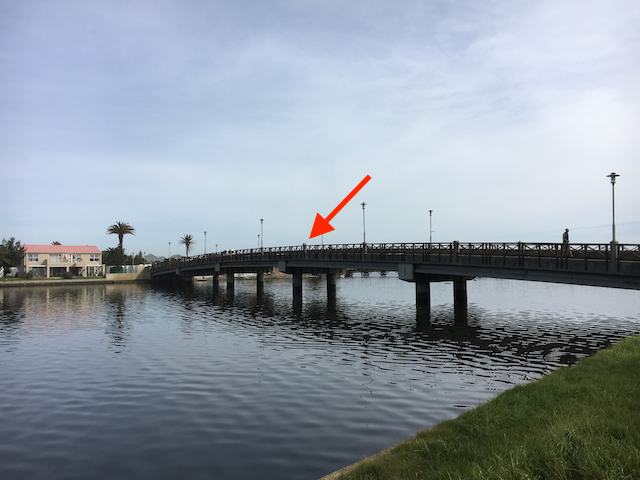
[picture p68: page 1]
