DewanPieterse/AudioRadar/Report/images/setupPDTest22.pdf

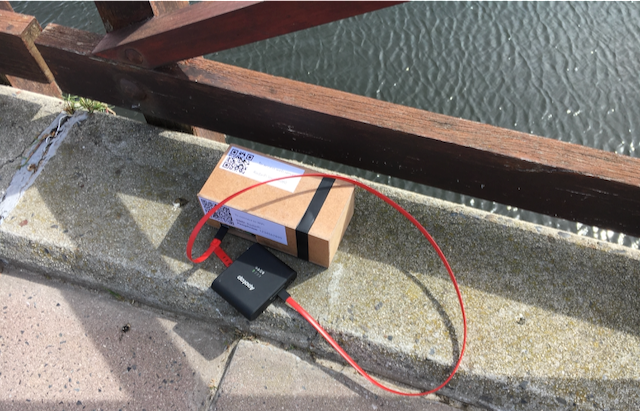
[picture p69: page 1]
