DewanPieterse/AudioRadar/Report/images/cw2results.pdf

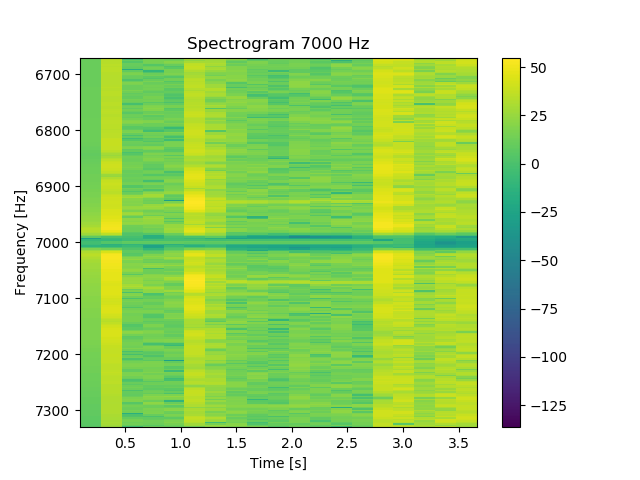
[picture p70: page 1]
