DewanPieterse/AudioRadar/Report/images/cw2results2.pdf

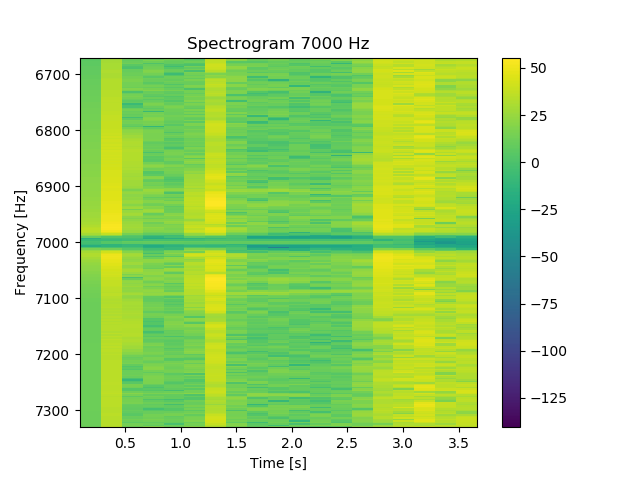
[picture p71: page 1]
