DewanPieterse/AudioRadar/Report/images/measuregolf.pdf

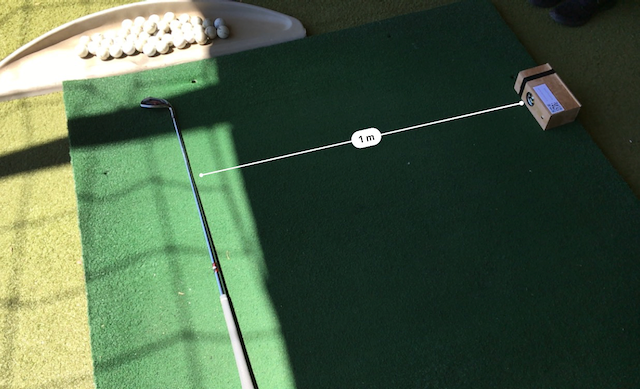
[picture p72: page 1]
