DewanPieterse/AudioRadar/Report/images/pulsedTest1-1.pdf

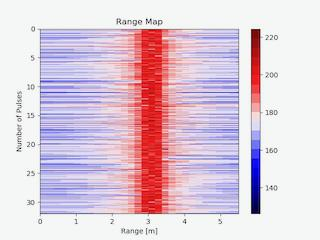
[picture p73: page 1]
