DewanPieterse/AudioRadar/Report/images/pulsedTest1-2.pdf

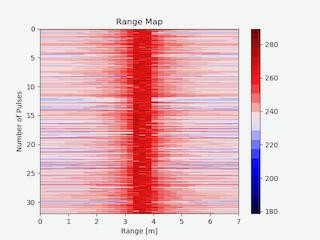
[picture p74: page 1]
