DewanPieterse/AudioRadar/Report/images/pulsedTest1-3.pdf

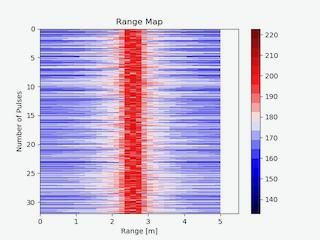
[picture p75: page 1]
