DewanPieterse/AudioRadar/Report/images/pulsedTest1-4.pdf

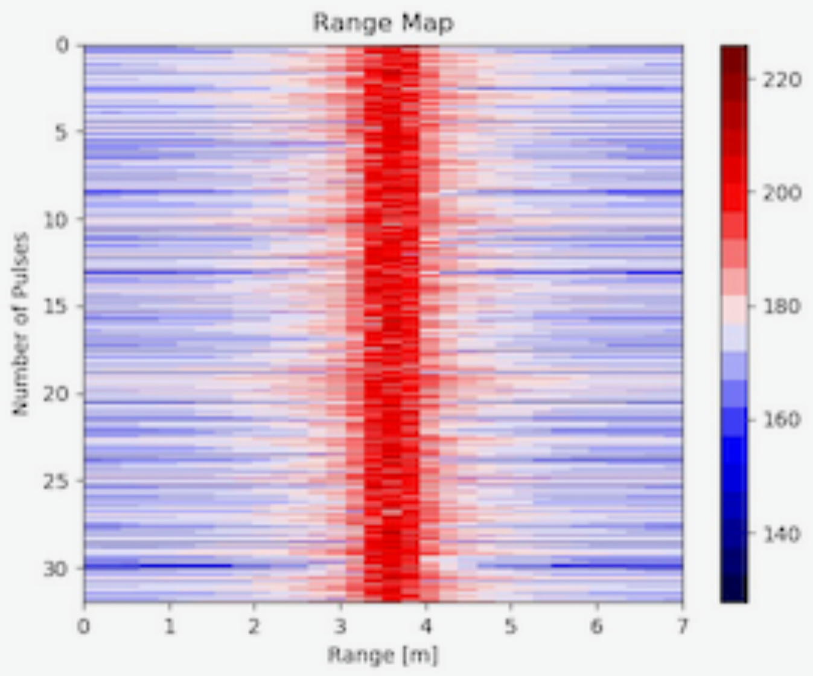
[picture p76: page 1]
