DewanPieterse/AudioRadar/Report/images/resultsCW1.pdf

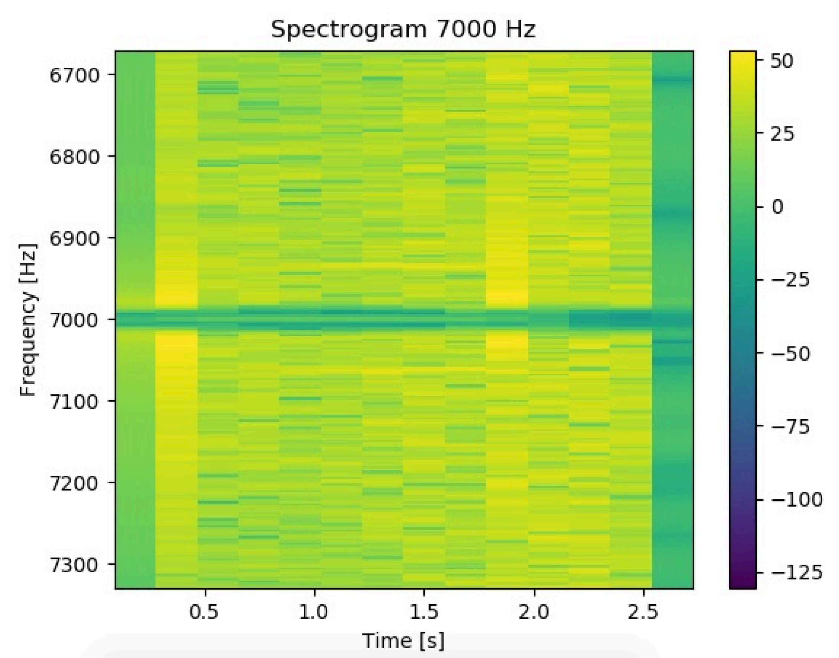
[picture p77: page 1]
