DewanPieterse/AudioRadar/Report/images/resultsCW2.pdf

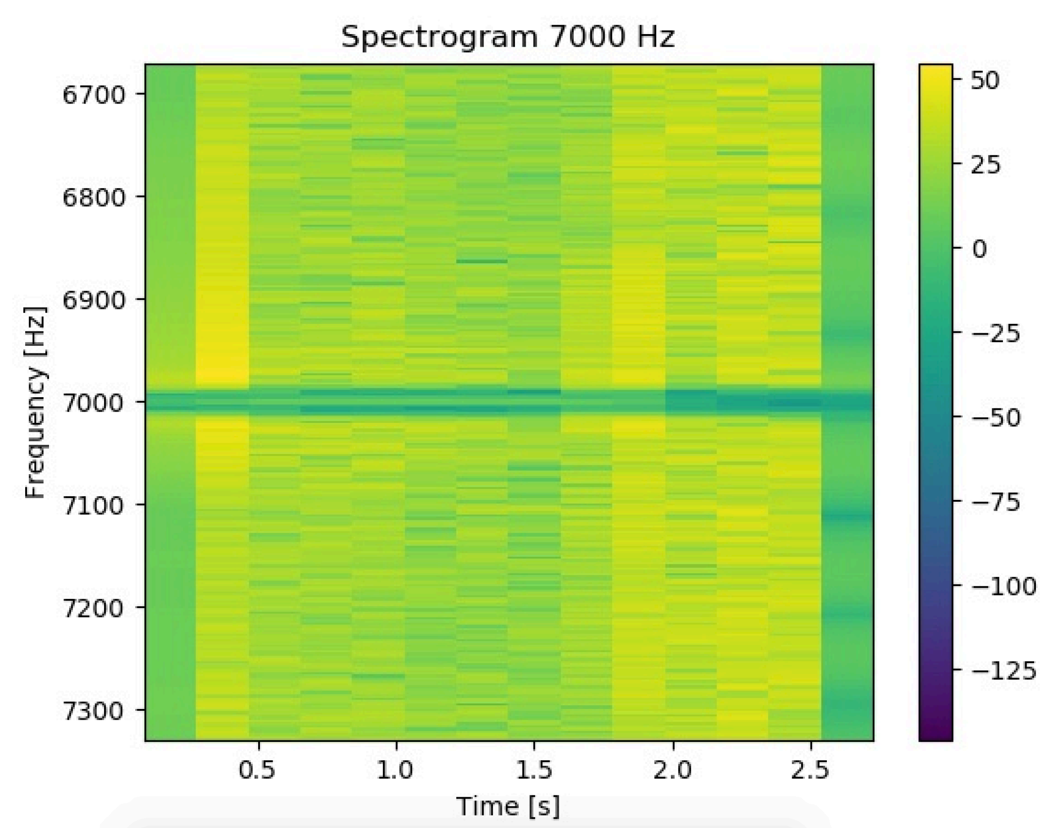
[picture p78: page 1]
