DewanPieterse/AudioRadar/Report/images/setupPDTest2Results.pdf

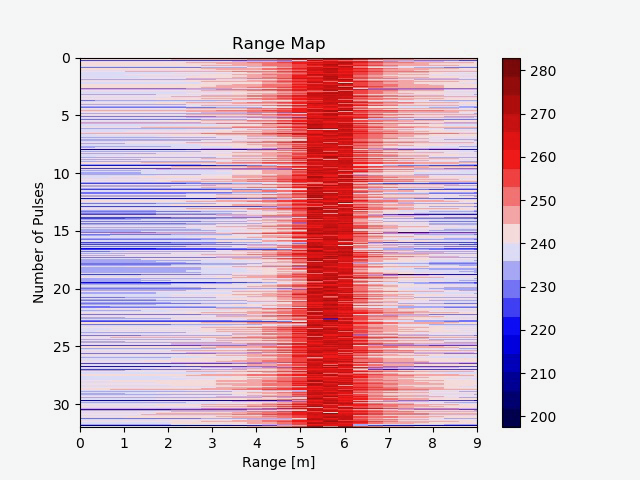
[picture p79: page 1]
