DewanPieterse/AudioRadar/Report/images/test.pdf

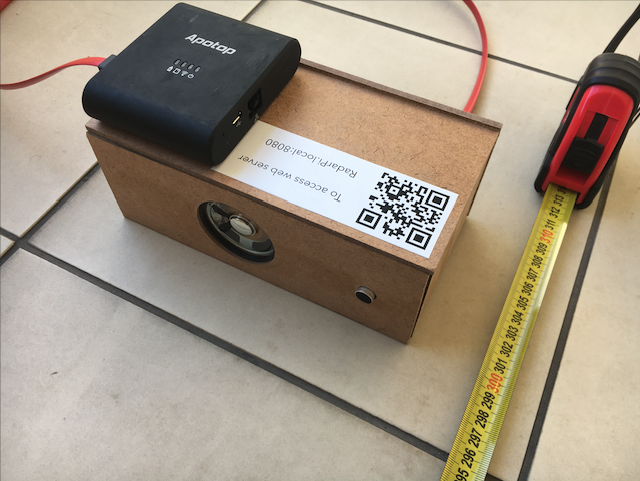
[picture p80: page 1]
