DewanPieterse/AudioRadar/Report/images/test1.pdf

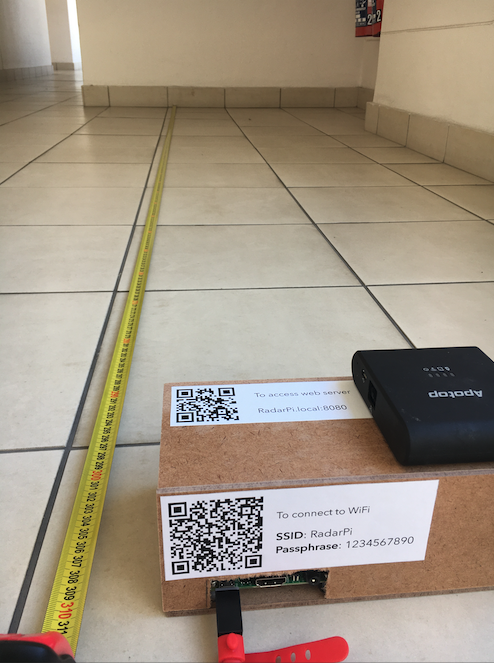
[picture p81: page 1]
