DewanPieterse/AudioRadar/Matlab/Testing Mics and Speakers/freq_response.xlsx

On table - 1m
Frequency | V_in | MAX9814 | MAX4466 | MAX9814edit | MAX4466edit | 1 | 2 | filename | Gain ( MAX 9814) | Gain ( MAX 4466) | Gain ( MAX 9814) edit | Gain ( MAX 4466) edit
5000 | 3.3 | 1.21 | 0.023 | 1.1132 | 1.32346 | 1.3800 | 0.0207 | scope_0 | -8.714571391 | -43.13572208 | -9.438814844 | -7.936062401
5500 | 3.3 | 1.27 | 0.031 | 1.1684 | 1.33162 | 1.1500 | 0.0316 | scope_1 | -8.294204378 | -40.54304492 | -9.018447832 | -7.882672611
6000 | 3.3 | 1.17 | 0.033 | 1.0764 | 1.33366 | 1.1900 | 0.0363 | scope_2 | -9.006561563 | -40 | -9.730805016 | -7.869376283
6500 | 3.3 | 0.8 | 0.036 | 0.736 | 1.33672 | 1.3400 | 0.0335 | scope_3 | -12.30847906 | -39.24422878 | -13.03272251 | -7.849469877
7000 | 3.3 | 0.77 | 0.037 | 0.7084 | 1.33774 | 0.9900 | 0.0396 | scope_4 | -12.64046429 | -39.00624432 | -13.36470775 | -7.842844534
7500 | 3.3 | 0.64 | 0.039 | 0.5888 | 1.33978 | 1.0000 | 0.0355 | scope_5 | -14.24667932 | -38.54898666 | -14.97092277 | -7.829608989
8000 | 3.3 | 0.65 | 0.046 | 0.598 | 1.34692 | 0.5300 | 0.0377 | scope_6 | -14.11201166 | -37.11512216 | -14.83625512 | -7.783442764
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
