DewanPieterse/AudioRadar/Matlab/Testing Mics and Speakers/IMG_0413.JPG

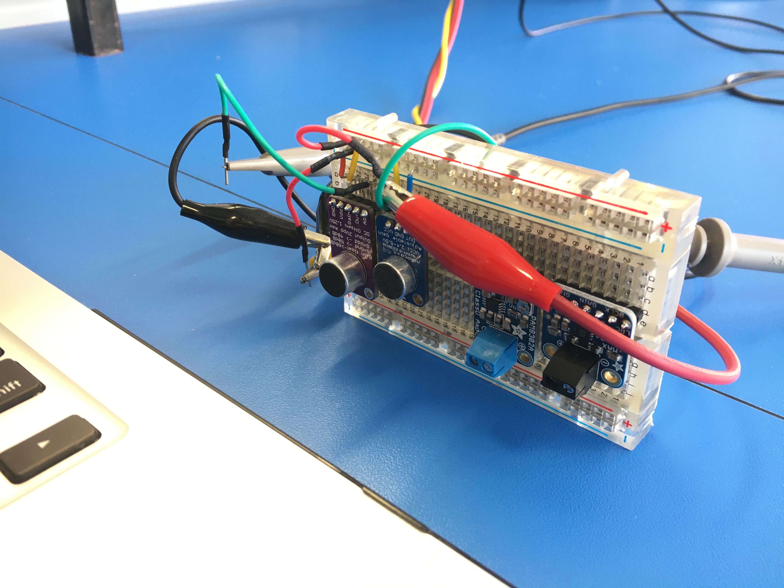
Matlab/Testing Mics and Speakers/IMG_0413.JPG
