DewanPieterse/AudioRadar/Matlab/Testing Mics and Speakers/IMG_0955.JPG

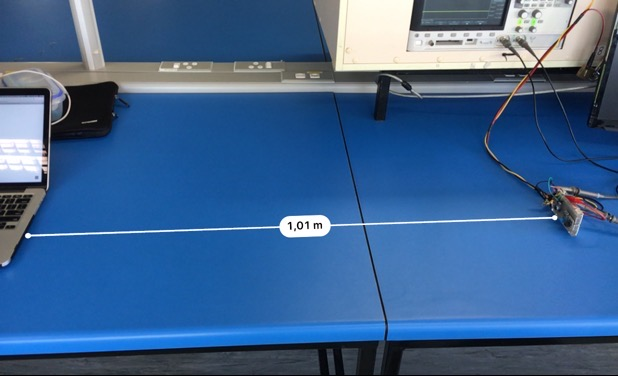
Matlab/Testing Mics and Speakers/IMG_0955.JPG
