DewanPieterse/AudioRadar/Matlab/Testing Mics and Speakers/IMG_5939.JPG

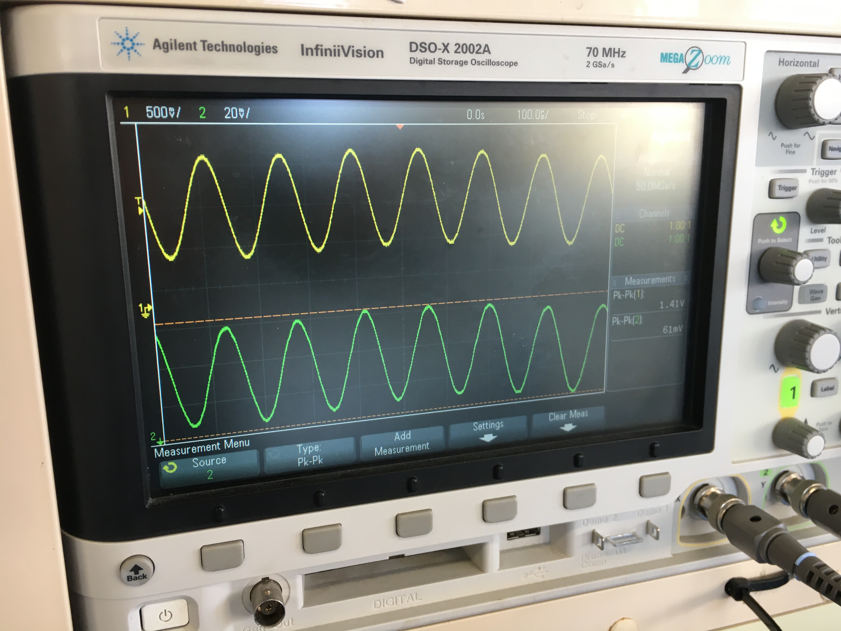
Matlab/Testing Mics and Speakers/IMG_5939.JPG
