DewanPieterse/AudioRadar/Matlab/Testing Mics and Speakers/IMG_7467.JPG

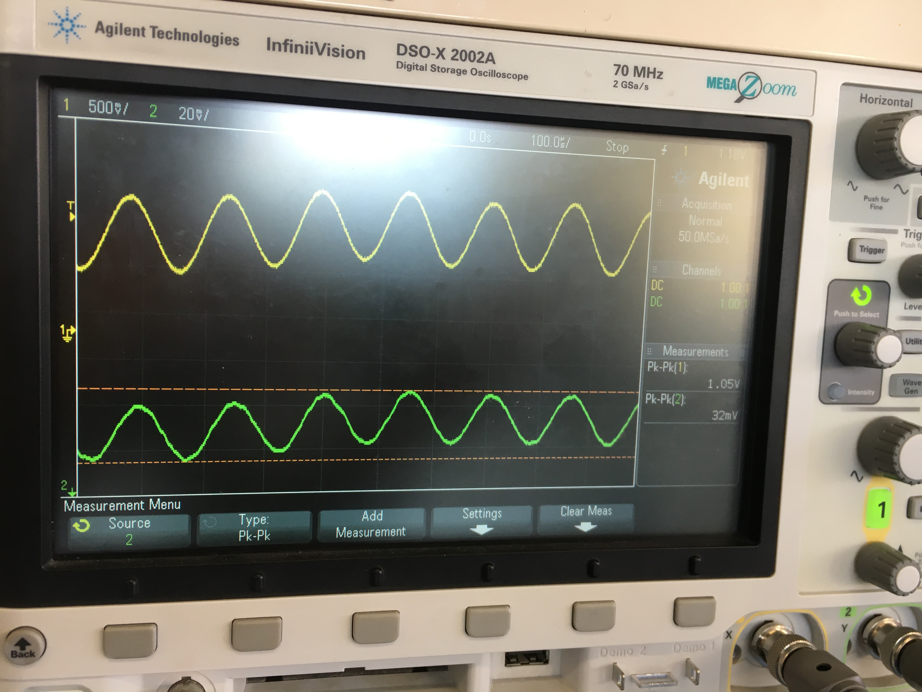
Matlab/Testing Mics and Speakers/IMG_7467.JPG
