DewanPieterse/AudioRadar/Matlab/Testing Mics and Speakers/IMG_7750.JPG

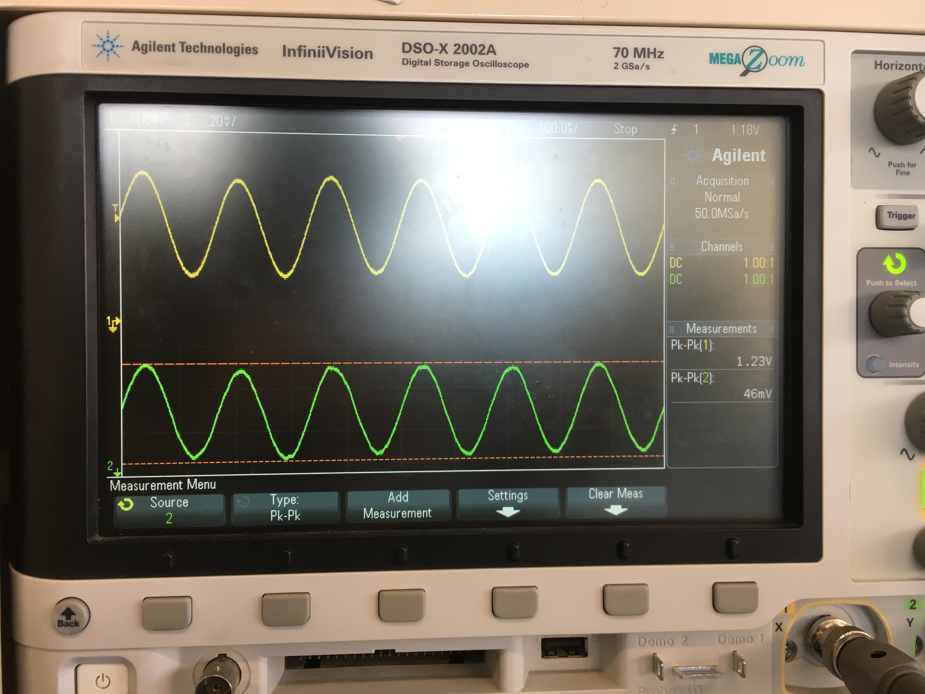
Matlab/Testing Mics and Speakers/IMG_7750.JPG
