DewanPieterse/AudioRadar/Matlab/Testing Mics and Speakers/IMG_7828.JPG

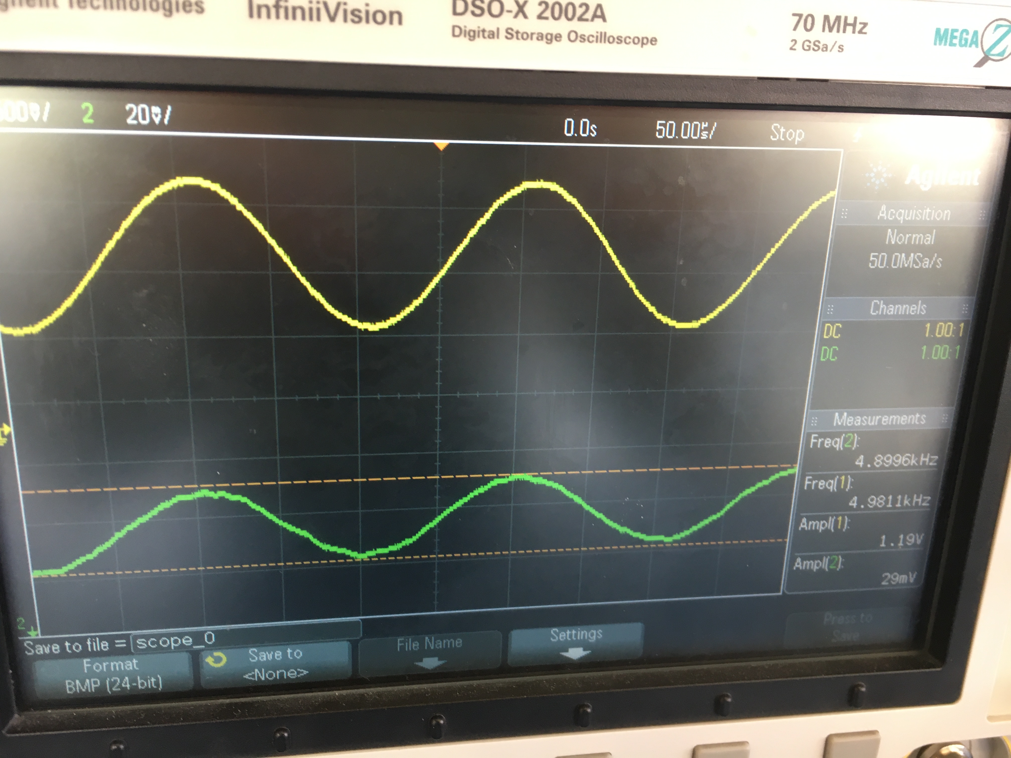
Matlab/Testing Mics and Speakers/IMG_7828.JPG
