DewanPieterse/AudioRadar/Matlab/Testing Mics and Speakers/Oscilloscope Screenshots/scope_0.png

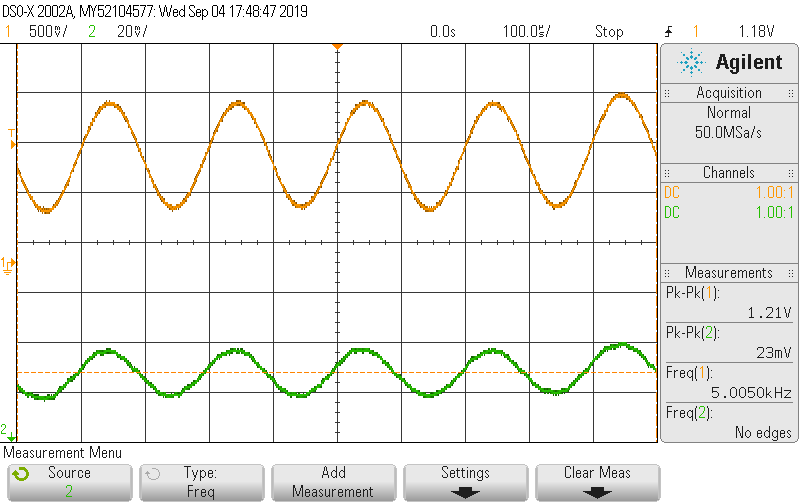
Matlab/Testing Mics and Speakers/Oscilloscope Screenshots/scope_0.png
