DewanPieterse/AudioRadar/Matlab/Testing Mics and Speakers/Oscilloscope Screenshots/scope_1.png

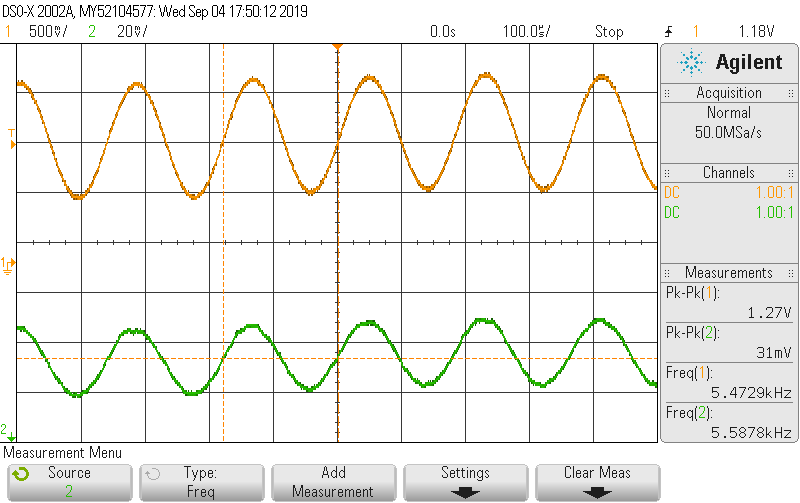
Matlab/Testing Mics and Speakers/Oscilloscope Screenshots/scope_1.png
