DewanPieterse/AudioRadar/Matlab/Testing Mics and Speakers/Oscilloscope Screenshots/scope_2.png

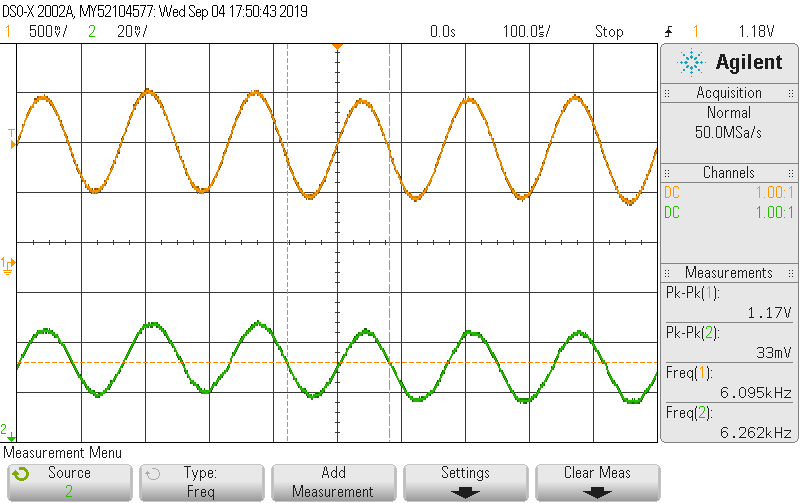
Matlab/Testing Mics and Speakers/Oscilloscope Screenshots/scope_2.png
