DewanPieterse/AudioRadar/Matlab/Testing Mics and Speakers/Oscilloscope Screenshots/scope_8.png

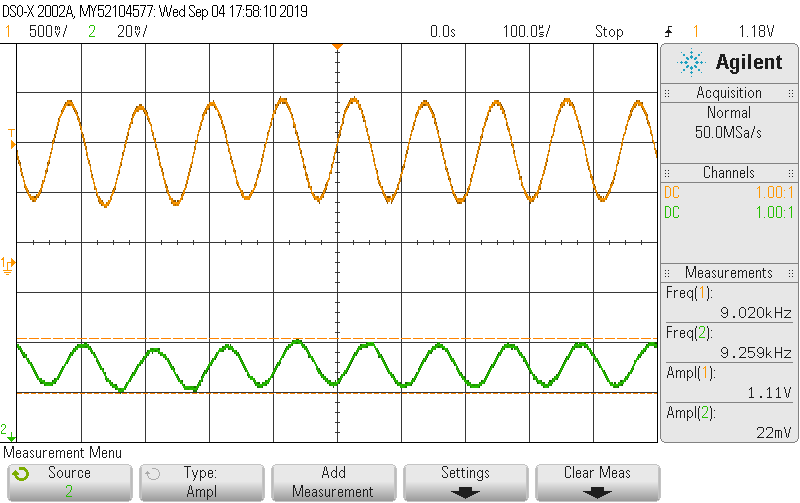
Matlab/Testing Mics and Speakers/Oscilloscope Screenshots/scope_8.png
