DewanPieterse/AudioRadar/Matlab/Testing Mics and Speakers/Oscilloscope Screenshots/scope_9.png

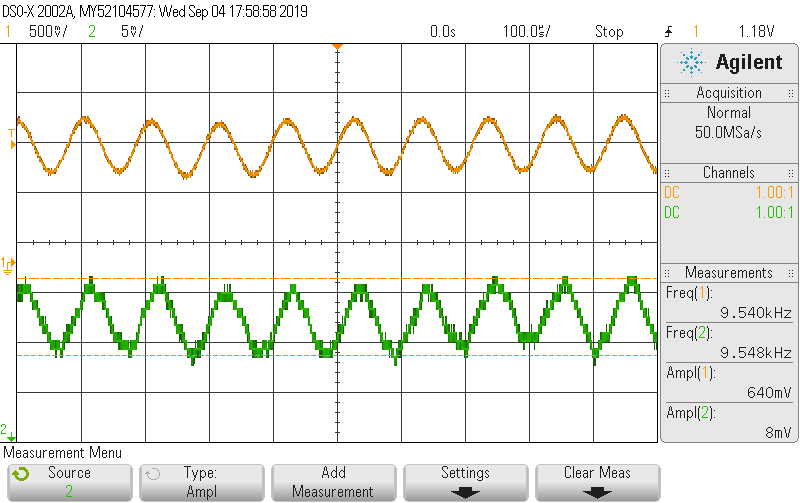
Matlab/Testing Mics and Speakers/Oscilloscope Screenshots/scope_9.png
