DewanPieterse/AudioRadar/Matlab/Testing Mics and Speakers/Oscilloscope Screenshots/scope_10.png

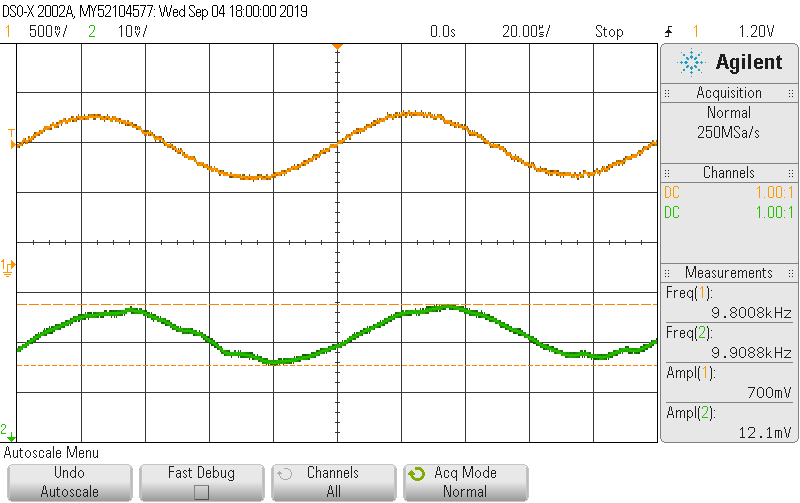
Matlab/Testing Mics and Speakers/Oscilloscope Screenshots/scope_10.png
