DewanPieterse/AudioRadar/Matlab/Testing Mics and Speakers/Oscilloscope Screenshots/scope_11.png

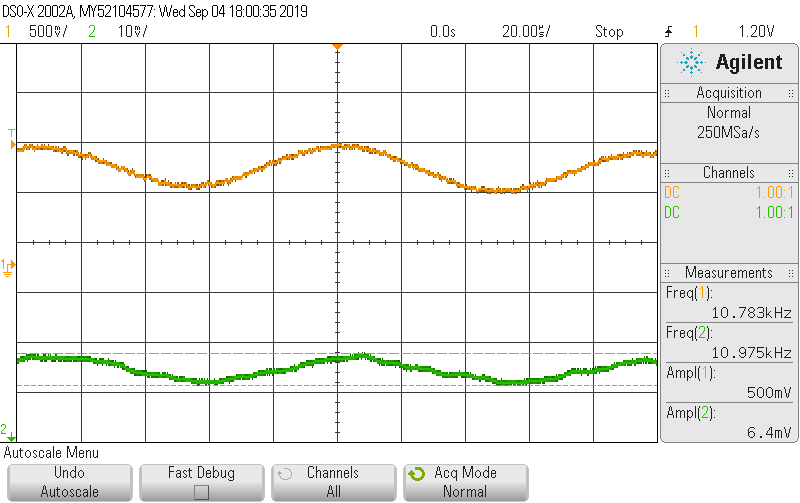
Matlab/Testing Mics and Speakers/Oscilloscope Screenshots/scope_11.png
