DewanPieterse/AudioRadar/Matlab/Testing Mics and Speakers/Oscilloscope Screenshots/scope_12.png

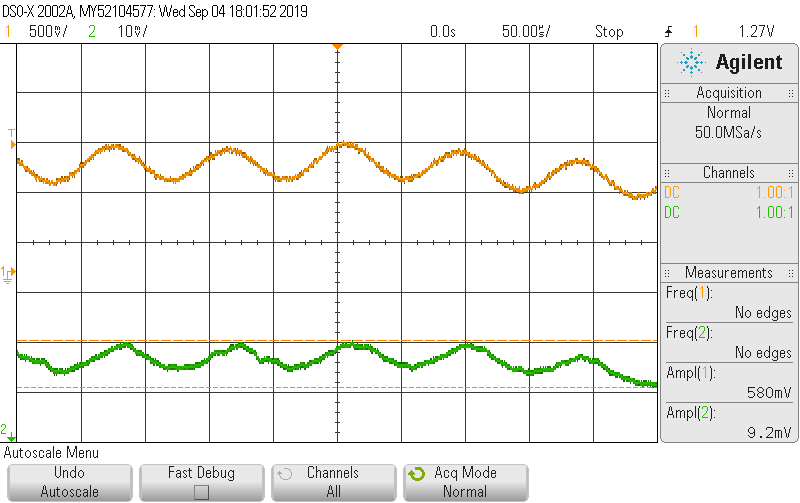
Matlab/Testing Mics and Speakers/Oscilloscope Screenshots/scope_12.png
