DewanPieterse/AudioRadar/Matlab/Testing Mics and Speakers/Oscilloscope Screenshots/scope_17.png

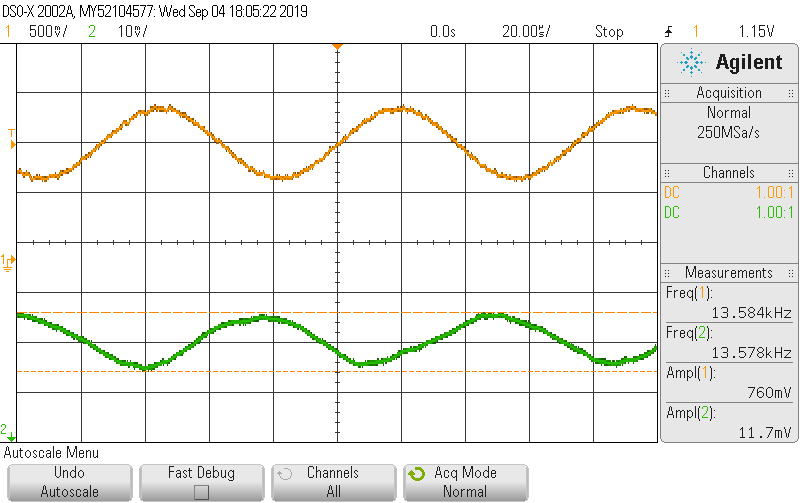
Matlab/Testing Mics and Speakers/Oscilloscope Screenshots/scope_17.png
