DewanPieterse/AudioRadar/Matlab/Testing Mics and Speakers/Oscilloscope Screenshots/scope_18.png

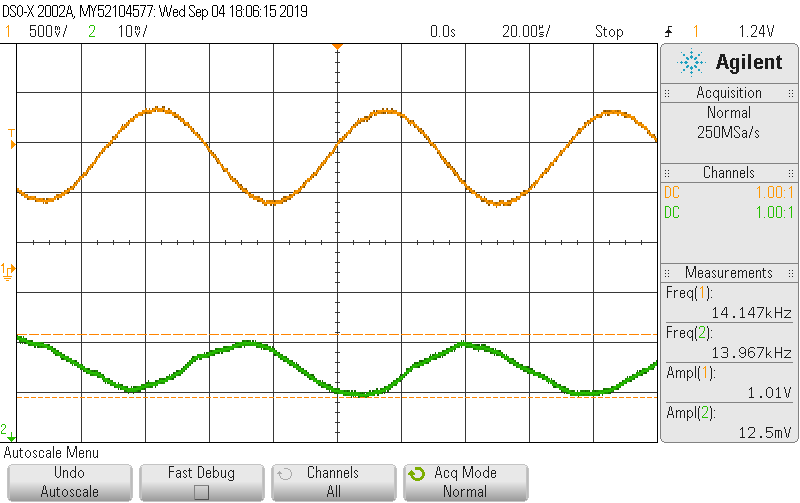
Matlab/Testing Mics and Speakers/Oscilloscope Screenshots/scope_18.png
