DewanPieterse/AudioRadar/Matlab/Testing Mics and Speakers/Oscilloscope Screenshots/scope_19.png

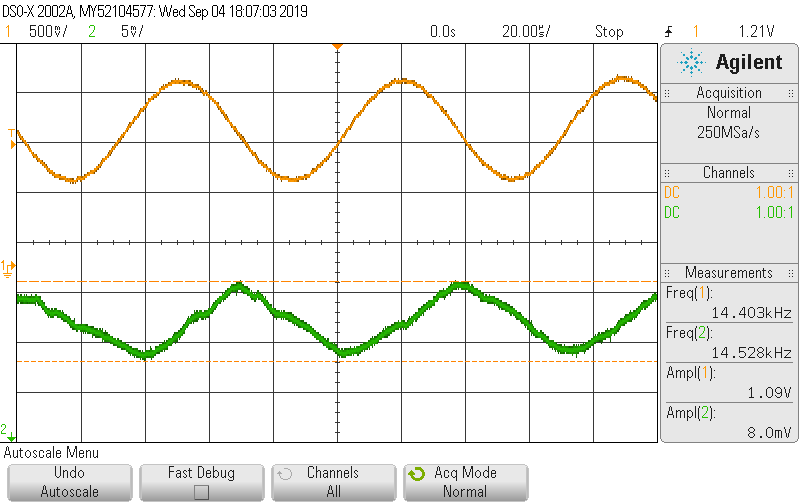
Matlab/Testing Mics and Speakers/Oscilloscope Screenshots/scope_19.png
