DewanPieterse/AudioRadar/Matlab/Testing Mics and Speakers/Oscilloscope Screenshots/scope_20.png

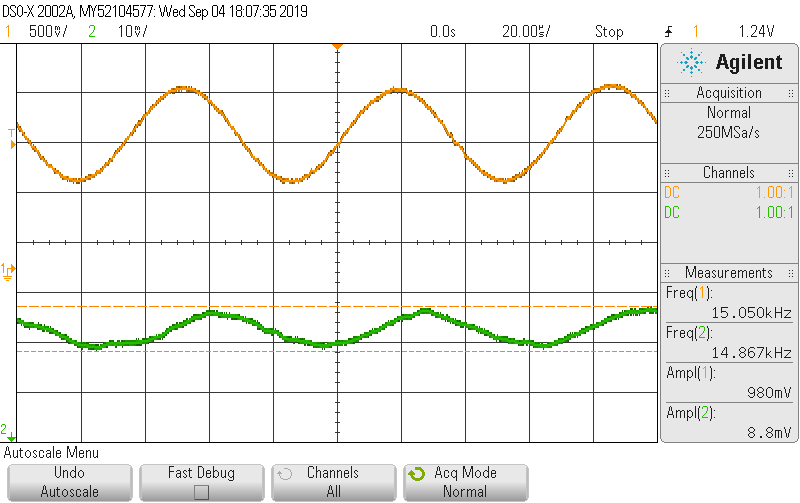
Matlab/Testing Mics and Speakers/Oscilloscope Screenshots/scope_20.png
