DewanPieterse/AudioRadar/Matlab/Testing Mics and Speakers/Suspended Mic Testing/scope_0.png

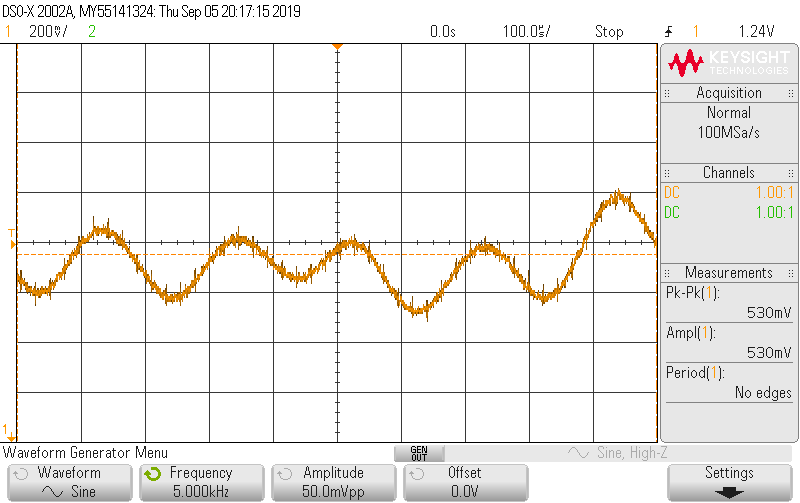
Matlab/Testing Mics and Speakers/Suspended Mic Testing/scope_0.png
