DewanPieterse/AudioRadar/Matlab/Testing Mics and Speakers/Suspended Mic Testing/scope_2.png

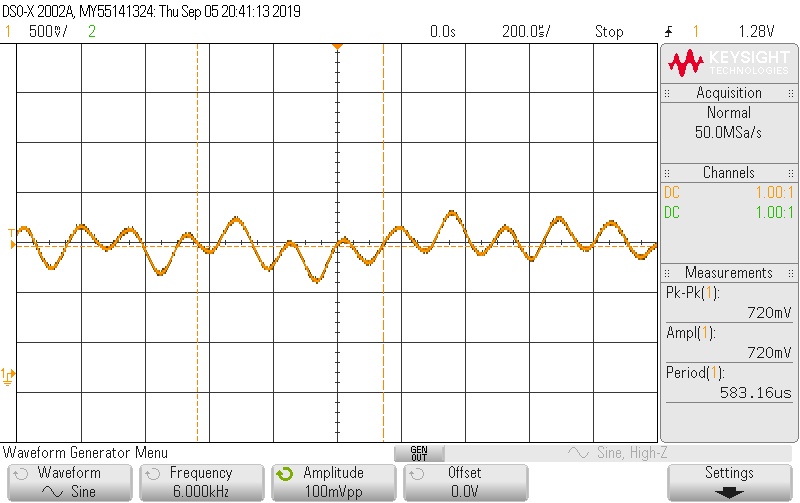
Matlab/Testing Mics and Speakers/Suspended Mic Testing/scope_2.png
