DewanPieterse/AudioRadar/Matlab/Testing Mics and Speakers/Suspended Mic Testing/scope_3.png

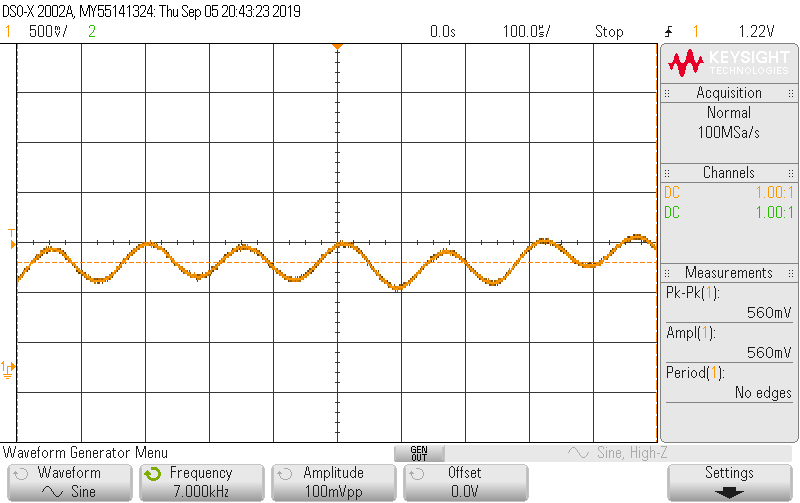
Matlab/Testing Mics and Speakers/Suspended Mic Testing/scope_3.png
