DewanPieterse/AudioRadar/Matlab/Testing Mics and Speakers/Suspended Mic Testing/scope_4.png

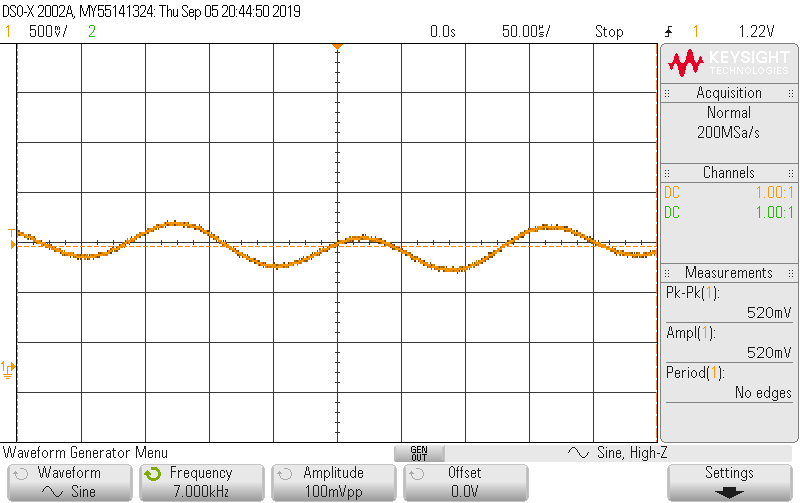
Matlab/Testing Mics and Speakers/Suspended Mic Testing/scope_4.png
