DewanPieterse/AudioRadar/Matlab/Testing Mics and Speakers/Suspended Mic Testing/scope_5.png

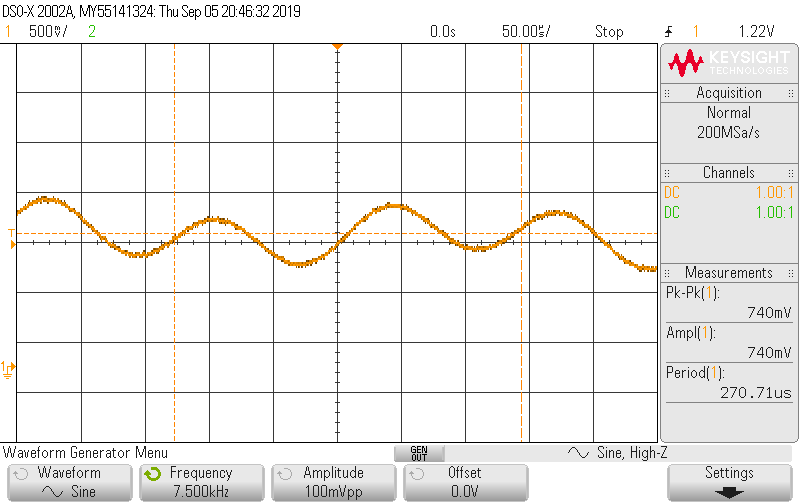
Matlab/Testing Mics and Speakers/Suspended Mic Testing/scope_5.png
