DewanPieterse/AudioRadar/Matlab/Testing Mics and Speakers/Suspended Mic Testing/scope_6.png

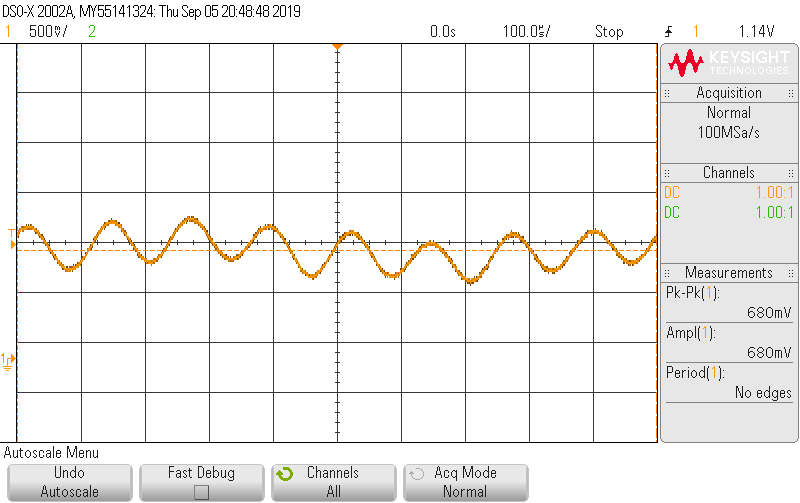
Matlab/Testing Mics and Speakers/Suspended Mic Testing/scope_6.png
