DewanPieterse/AudioRadar/Matlab/Testing Mics and Speakers/Suspended Mic Testing/scope_8.png

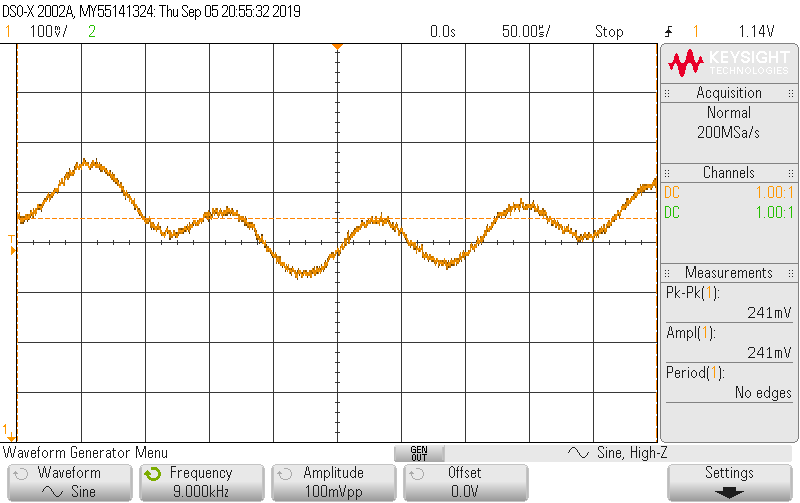
Matlab/Testing Mics and Speakers/Suspended Mic Testing/scope_8.png
