DewanPieterse/AudioRadar/Matlab/Testing Mics and Speakers/Suspended Mic Testing/scope_9.png

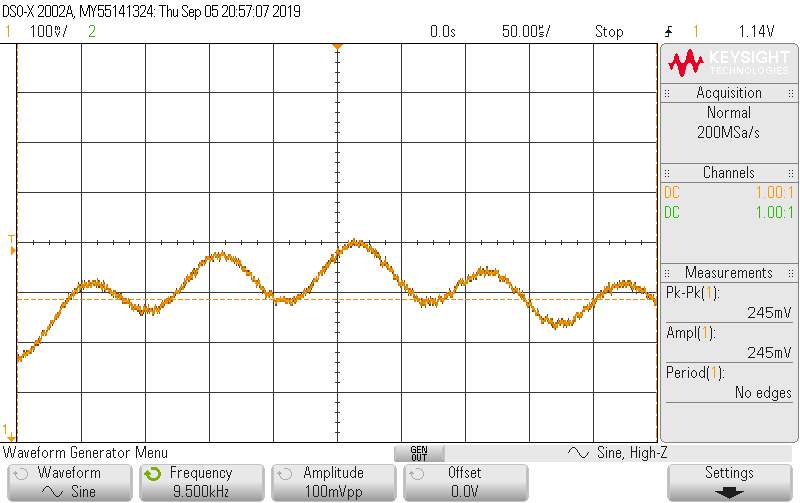
Matlab/Testing Mics and Speakers/Suspended Mic Testing/scope_9.png
