DewanPieterse/AudioRadar/Matlab/Testing Mics and Speakers/Suspended Mic Testing/scope_10.png

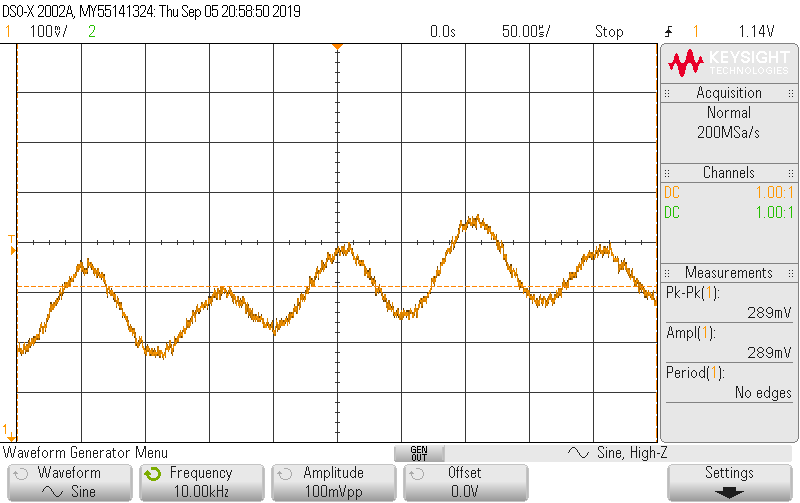
Matlab/Testing Mics and Speakers/Suspended Mic Testing/scope_10.png
