DewanPieterse/AudioRadar/Matlab/Testing Mics and Speakers/Suspended Mic Testing/scope_11.png

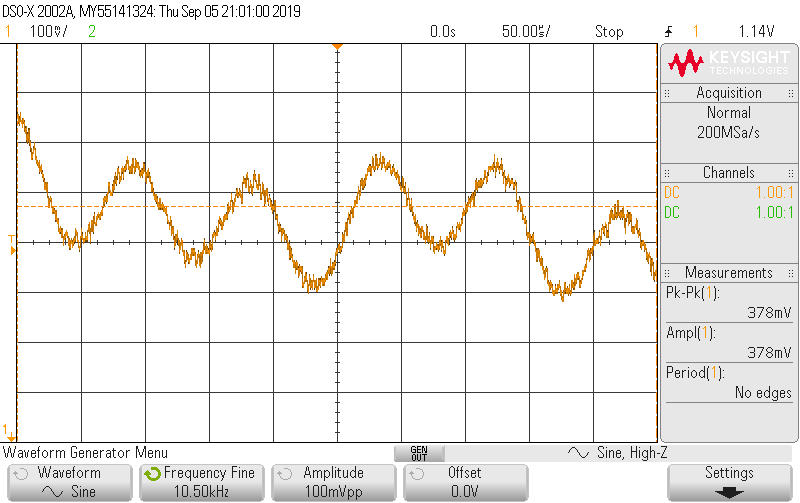
Matlab/Testing Mics and Speakers/Suspended Mic Testing/scope_11.png
