DewanPieterse/AudioRadar/Matlab/Testing Mics and Speakers/Suspended Mic Testing/scope_12.png

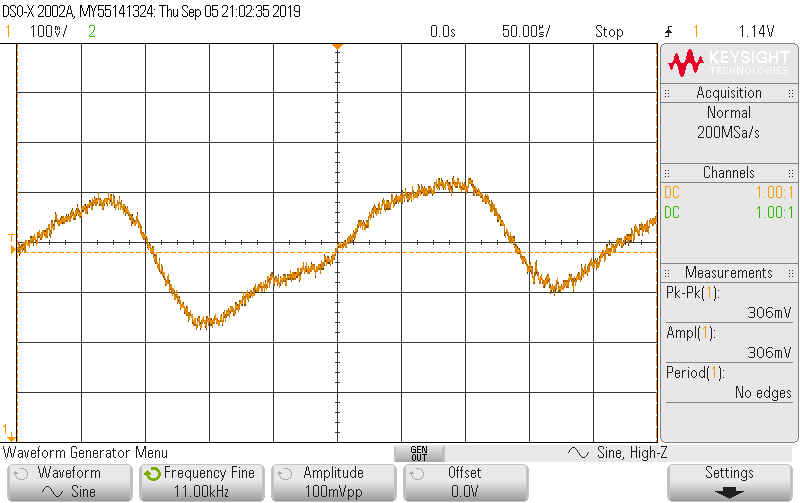
Matlab/Testing Mics and Speakers/Suspended Mic Testing/scope_12.png
