DewanPieterse/AudioRadar/Matlab/Testing Mics and Speakers/Suspended Mic Testing/scope_13.png

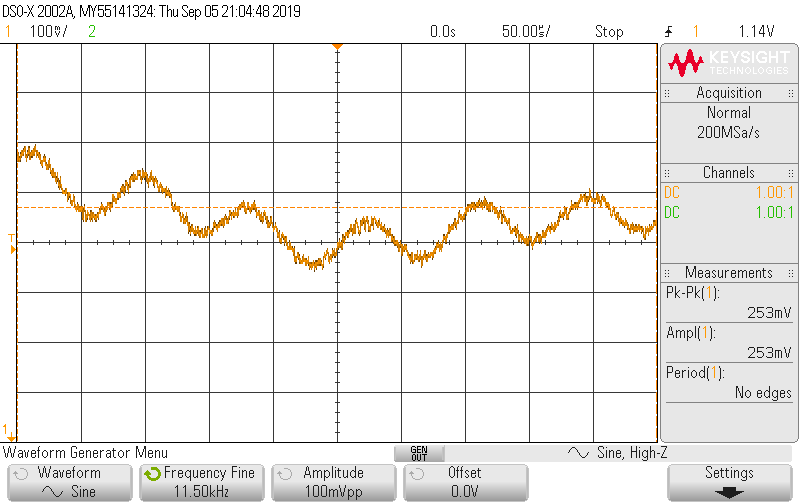
Matlab/Testing Mics and Speakers/Suspended Mic Testing/scope_13.png
