DewanPieterse/AudioRadar/Matlab/Testing Mics and Speakers/Suspended Mic Testing/scope_14.png

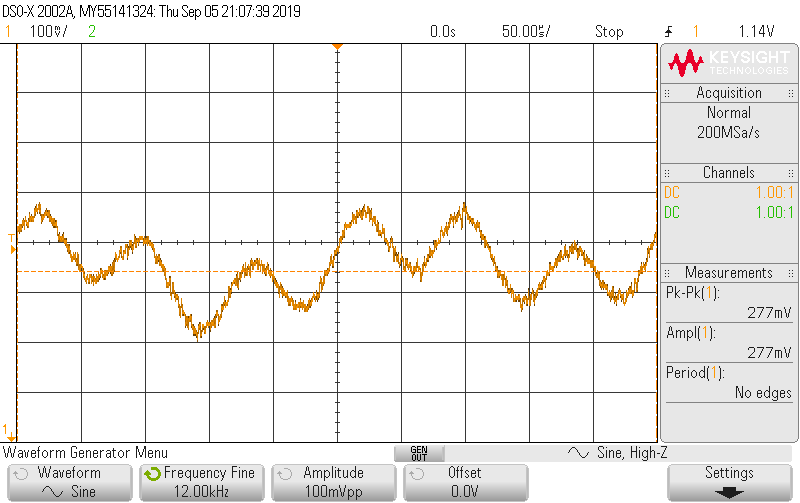
Matlab/Testing Mics and Speakers/Suspended Mic Testing/scope_14.png
