DewanPieterse/AudioRadar/Matlab/Testing Mics and Speakers/Suspended Mic Testing/scope_15.png

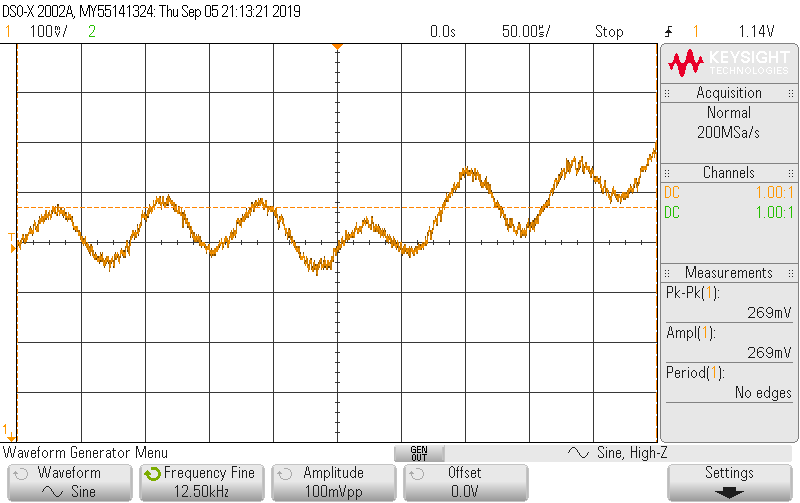
Matlab/Testing Mics and Speakers/Suspended Mic Testing/scope_15.png
