DewanPieterse/AudioRadar/Matlab/Testing Mics and Speakers/Suspended Mic Testing/scope_17.png

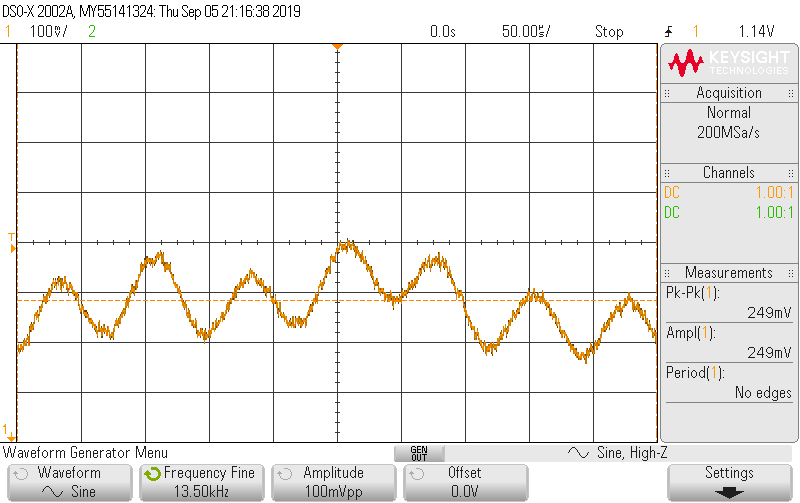
Matlab/Testing Mics and Speakers/Suspended Mic Testing/scope_17.png
