DewanPieterse/AudioRadar/Matlab/Testing Mics and Speakers/Suspended Mic Testing/scope_18.png

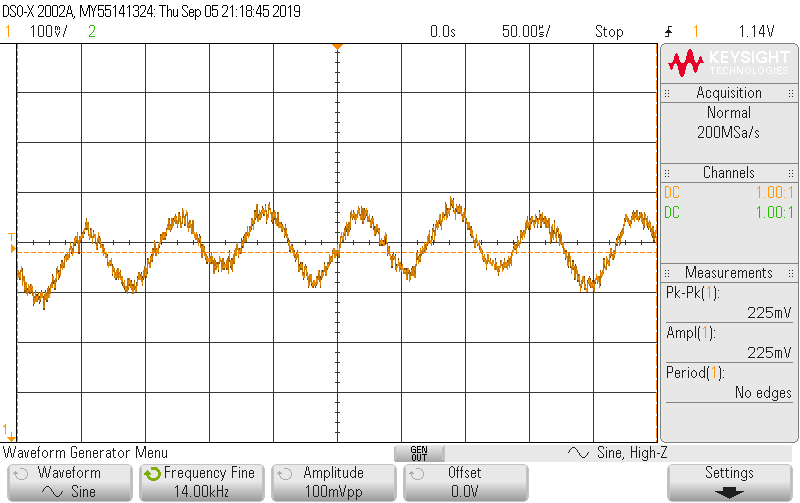
Matlab/Testing Mics and Speakers/Suspended Mic Testing/scope_18.png
