DewanPieterse/AudioRadar/Matlab/Testing Mics and Speakers/Suspended Mic Testing/scope_19.png

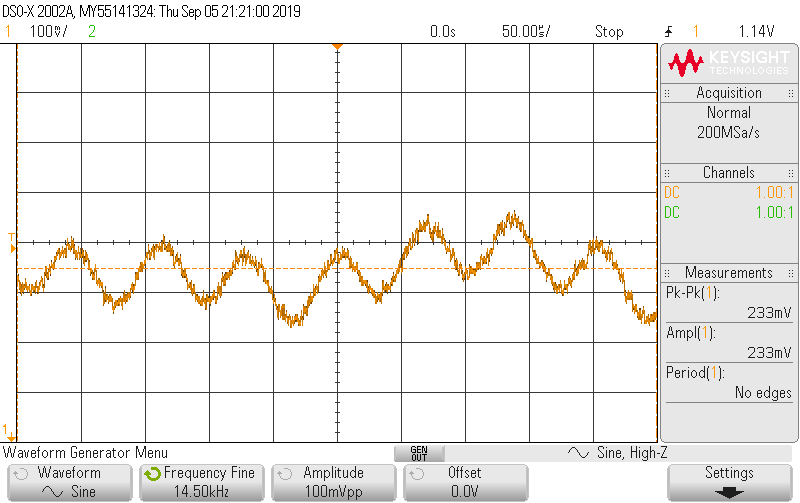
Matlab/Testing Mics and Speakers/Suspended Mic Testing/scope_19.png
