DewanPieterse/AudioRadar/Matlab/Testing Mics and Speakers/Suspended Mic Testing/scope_20.png

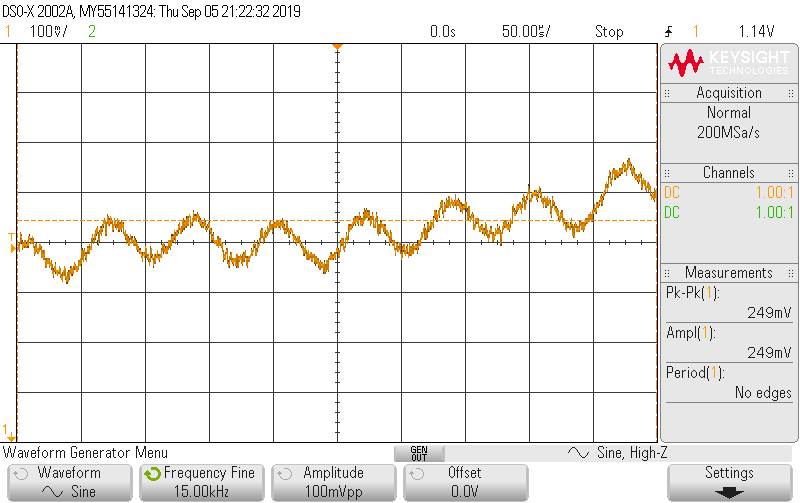
Matlab/Testing Mics and Speakers/Suspended Mic Testing/scope_20.png
