DewanPieterse/AudioRadar/(list of files, drawings)

Other design files:
RadarPi.fzz
