DewanPieterse/AudioRadar/RadarPi/testSerial.py

import serial
import time

ser = serial.Serial('/dev/ttyACM0', 9600) # ttyACM1 for Arduino board

readOut = 0   #chars waiting from laser range finder

print ("Starting up")
connected = False
commandToSend = s44100 # get the distance in mm

while True:
    print ("Writing: ",  commandToSend)
    ser.write(str(commandToSend).encode())
    time.sleep(1)
    while True:
        try:
            print ("Attempt to Read")
            readOut = ser.readline().decode('ascii')
            time.sleep(1)
            print ("Reading: ", readOut) 
            break
        except:
            pass
    print ("Restart")
    ser.flush() #flush the buffer
