DewanPieterse/AudioRadar/(commit log)

2019-08-05 Added code to read an analog input with MCP3008 on pin 22 on rpi.
2019-09-07 New file where testing the connection between arduino and pi
2019-09-09 Added Freq response files and testing scripts
    [10000.xlsx, 10500.xlsx, 11000.xlsx, 11500.xlsx, 12000.xlsx, 12500.xlsx, 13000.xlsx, 13500.xlsx]
2019-09-09 Working version of pulseGenerator
    Pulsegenerator works fine now. train not working yet.
    [waveGenerator.py]
2019-09-16 sounds play on submit button click on webapp.py
2019-09-17 Testing the serial interface teensy/python
2019-09-20 Testing and Struggling ADC
2019-10-05 Added volume controls
    [generator_config.txt]
2019-10-05 minor changes to freq.xls
    [freq_response edit.xlsx]
2019-10-08 Testing stuff, no real changes
    [RadarPi.fzz]
2019-10-14 clean up
    [freq_response edit.xlsx, freq_response.xlsx]
2019-10-14 Rename folder
    [10000.xlsx, 10500.xlsx, 11000.xlsx, 11500.xlsx, 12000.xlsx, 12500.xlsx, 13000.xlsx, 13500.xlsx]
